minbiocabanon/DoMini/videosurveillance/README.md

Videosurveillance
=====

Ce répertoire contient un fichier texte avec mes notes ayant servi à tester l'API de mes cameras AXIS.
