minbiocabanon/DoMini/periph/poele/README.md

Hardware

	mesure capacité reservoir par ultrason :
	http://www.seeedstudio.com/wiki/Grove_-_Ultrasonic_Ranger

==== Software
Poele.ino
   need library mstimer2 : http://playground.arduino.cc/Main/MsTimer2
   
   ultrasonic ranger github   
   https://github.com/Seeed-Studio/Grove_Ultrasonic_Ranger
