minbiocabanon/DoMini/serveur/bdd/pytribdd/README.md

pytribdd.py
========

Script lancé manuellement en cas de besoin (en général, le script de nettoyage de la bdd quotidien n'a pas fonctionné)

#OBLIGATOIRE : utilisation avec une date en arguments
	$python pytribdd.py 2017-01-01
	
	de 2017-01-01 à 'maintenant' : ne conserve qu'une donnée par heure et le min/max pour les tables indiquées dans le code
