minbiocabanon/DoMini/serveur/bdd/tribdd/README.md

pytribdd.py
========
Script lancé quotidiennement par une action CRON

#utilisation sans arguments
	$python pytribdd_edf.py 
	
	ne converse que les releves de debut de chaque heure pour  le jour J - NB_JOUR (NB_JOUR en dur dans le code)
	
#utilisation avec une date en arguments
	$python pytribdd.py 2017-01-01
	
	ne converse que les releves de debut de chaque heure pour  l'intervalle de temps : "date en argument" jusqu'à "jour actuel - NB_JOUR" (NB_JOUR en dur dans le code)

========
A faire avant de compiler : 
 - Renomer passwd_.h en passwd.h
 - Compléter les informations pour la connexion à MySQL :
	- user -> nom de l'utilisateur de la base
    - password -> mot de passe de l'utilisateur 
    - database = "domotique"; ("domotique" est le nom de la base par défaut, à modifier si vous avez changer le nom)
	- server = "localhost"; (ne pas modifier sauf si vous savez de ce que vous faite)
