minbiocabanon/DoMini/periph/voletroulant/Cablage moteur Somfy.pdf

Branchement, cablage moteur Somfy de store banne électrique | Page 1
http://www.conseils-store.com/index.php?store=bead_mess&id=1872 | 05/02/2011 10:57:17

ACCUEIL
Conseils store

FORUM
sur les stores

CONSEILS SUR LES STORES POUR DECORER ET PROTEGER FENETRE , VERANDA ET TERRASSE

La motorisation
invisible
Découvrez notre
motorisation invisible
de volets battants !
www.motorisation-habitat. com
Volet Roulant
0561190190
Installation -
Dépannage Toulouse
Volet Roulant - Volet
Electrique...
toulouse.accord-assistance .fr

mdp motor
Micromoteurs toutes
technologies 30000
solutions , livraison
48h
www.mdpmotor.fr

Store
Large Gamme de
Stores Tous Les Sites
Marchands Sont Ici !
www.LeGuide.com/Stores

Store Banne
Vous cherchez un
store banne?
Comparez les prix des
stores !
Cherchons.com/Store_
banne
Câblage Téléphonique | Découvrez nos solutions pour réseau mise en place | & | maintenance | www.miditelecom.fr
Vente store enrouleur | Découvrez nos nombreux modèles de stores à enrouleur, | à partir de | 10€ | www.ParlonsDeco.fr/Store -
*Nos Stores *SUN PROTECT | Stores extérieurs, | store terrasse, | Brises soleil, | Voiles d'ombrage | www.sunprotect.fr
Stores pour Fenetres | Jusqu'à - | 65 | % | de remises sur nos Stores,Films Solaires et Film Déco. | www.StoreSurMesure.com

Lecture du message : stores , moteur et motorisation

Retour Accueil du Forum

SUJET : Branchement, cablage moteur Somfy de store banne électrique Email (anti- spam) : mathieu .fougs_- at- _orange .fr - Posté le : 25- 04- 2009
Titre : Branchement , cablage moteur Somfy de store banne électrique

Bonjour.
Étant novice en électricité , je recherche le branchement électrique pour raccorder un store banne de marque Monsieur Store avec une motorisation SOMFY à moteur SLT 50 .

J'ai acheté le store électrique d' occasion à peine 300 euros à mon voisin qui a déménagé . Il n'a plus la notice pour brancher le moteur du store banne et le programmer.

Il y a 4 fils qui sortent du moteur : bleu , noir, marron et jaune-vert. J 'ai une idée de branchement mais je préfère être sûr en ayant le bon schéma de câblage.
Merci d'avance pour vos réponses.

Sujet / réponse de : Schéma cablage

Email (anti- spam) : dev-premierprix _- at- _voila.fr - Posté le : 30 -06 -2009 Titre : Schéma de raccordement de motorisation Somfy de store banne

Bonjour,

Avant de parler électricité , il faut avant tout parler sécurité.

AVANT-PROPOS : des consignes de sécurité importantes à connaitre.
Le raccordement d’une motorisation de store banne (ou volet roulant) doit être effectué en conformité avec la norme NFC 15- 100. En électricité domestique, il y a des dangers de blessure par électrocution . Le raccordement doit être fait par un technicien qualifié et agrée!
De plus , si vous ne branchez pas correctement votre motorisation de store, vous risquez de faire un court- circuit et d’abimer le moteur. Le non-respect des instructions d’installation annule la responsabilité du constructeur et la garantie sur le produit .
Ne s'improvise pas électricien qui veut. Dans l' électricité domestique, il y a des normes, il y a des risques de chocs électriques, il y a des façons de câbler...
Si vous n' êtes pas un bricoleur compétent et averti , il faut faire raccorder la motorisation de votre store banne par une personne qualifiée.
En outre, il faut tenir les personnes à distance de l’installation tant que celle-ci n’est pas terminée. Avant d’intervenir sur l’installation , il faut impérativement couper le disjoncteur sur votre tableau électrique en amont. Enfin, lors de la connexion, il convient de respecter les prescriptions des entreprises de distribution d’ électricité locales, ainsi que les directives pour locaux mouillés et humides selon VDE 0100.

Le câblage de votre motorisation de marque Somfy, actionneur SLT 50 :
Ci- dessous un extrait de la documentation technique Somfy, actionneurs SLT 50 - SLT 60, moteurs spécifiques pour store banne coffre.

Recommandation de la notice technique Somfy
Les appareils avec câble en PVC de type H05 - VVF doivent être réservés aux usages internes , sauf si les câbles sont mis sous conduit.
Attention : afin d'être conforme à la norme d’installation NFC 73800, vous devez prévoir en amont sur le circuit électrique, un dispositif de coupure omnipolaire dont la distance d'ouverture des contacts est de 3mm minimum. Ces instructions concernant la section des câbles font références aux normes électriques françaises et sont données à titre indicatif.

Schéma de câblage, branchement du moteur Somfy SLT 50 - SLT 60 :

Branchement, cablage moteur Somfy de store banne électrique | Page 2

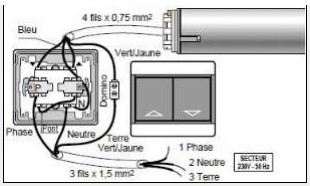
[picture p57: figure]
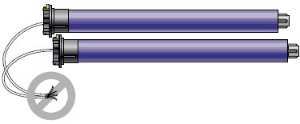
[picture p58: figure]
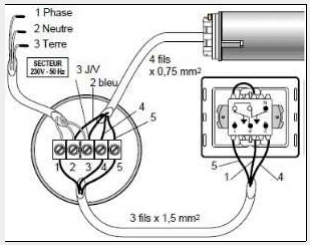
[picture p59: figure]

http://www.conseils-store.com/index.php?store=bead_mess&id=1872 | 05/02/2011 10:57:17

Dans le cas de plusieurs actionneurs Somfy :

Ne pas brancher deux ou plusieurs actionneurs sur le même inverseur . Utilisez impérativement une commande groupée. Ne pas utiliser les interrupteurs utilisés couramment pour les éclairages domestiques.
Ne pas brancher deux interrupteurs inverseurs sur une motorisation. Ces appareils sont munis d’une fixation du type M : si le câble d’alimentation de cet appareil est endommagé, il doit être remplacé par le câble d’alimentation spécial ( choisir la référence dans le catalogue de SOMFY).

Je viens de vous envoyer la documentation technique complète par mail de l’actionneur SLT 50 – SLT 60. Cela étant, n’ oubliez pas que sans compétence en électricité , vous devez vous adresser à un installateur agrée.

Pour vous informer sur les moteurs de store : Store electrique

Sujet / réponse de : Store

Email (anti- spam) : vietrce_- at- _yahoo.fr - Posté le : 23- 01- 2010
Titre : Toile de store electrique

Je souhaite changer les toiles de mes stores électriques .
Je n'arrive pas à trouver de distributeurs. De plus quels sont les caractéristiques à connaitre sachant que je n'ai aucune documentation sur les stores que j'ai acheté avec la maison ?
Merci d'avance.

Sujet / réponse de : François

Email (anti- spam) : stores 33_-at-_orange.fr - Posté le : 23- 01 -2010 Titre : RE : Toile de store

Bonjour,

Vous allez être obligé de passer par un Storiste , les caractéristiques à connaitre sont la longueur et la largeur du store, et si le tube d'enroulement et la barre de charge son a gorge ou à clips , avec une photo de profil rien de plus facile.

Cordialement ,
François de Stores 33 , Storiste en Gironde, Tel 06 24 63 36 85

Branchement, cablage moteur Somfy de store banne électrique | Page 3
http://www.conseils-store.com/index.php?store=bead_mess&id=1872 | 05/02/2011 10:57:17

Sujet / réponse de : Store

Email (anti- spam) : dev-premierprix _- at- _voila.fr - Posté le : 23 -01 -2010 Titre : RE : Changer la Toile de store

Pour vous informer sur les toiles de store banne :

Conseils pour choisir une toile de store banne : Toile store banne
Vous trouverez quelques critères de choix, du premier prix jusqu'à la toile haut de gamme...

Conseils pour changer une toile de store banne : Changer, remplacer toile store banne Vous trouverez dans cet article tout un tas d'infos pour remplacer la toile de son store banne.

Sujet / réponse de : vincent

Email (anti- spam) : mvincentleroy_-at-_gmail.com - Posté le : 17 - 04- 2010
Titre : RE : Branchement, cablage moteur Somfy de plusieurs stores

Merci pour ces beaux schémas de câblage.

Pour ma part, j'ai 2 moteurs + 2 moteurs. Comment dois- je mis prendre ? On m' a parlé de GR3 ? c' est quoi ? pourquoi ? Comment ?

Merci.

Sujet / réponse de : François

Email (anti- spam) : stores 33_-at-_orange.fr - Posté le : 17- 04 -2010
Titre : RE : Branchement, cablage moteur Somfy de store banne électrique

Bonjour,

"( ...) comment dois-je mis prendre ?"
Pour faire quoi ? Avec quoi ?

Merci d'exposer clairement votre problème si vous voulez une réponse.

Quel type d'installation avez- vous précisément ? Qu'avez- vous comme équipement : marque, modèle , à commande radio ou filaire ... ?
Que voulez- vous faire exactement ? une commande groupée de plusieurs stores ?

Cordialement ,
François de Stores 33 , Storiste en Gironde, Tel 06 24 63 36 85

Sujet / réponse de : Vincent

Email (anti- spam) : mvincentleroy_-at-_gmail.com - Posté le : 19 - 04- 2010 Titre : RE : Branchement, cablage moteur Somfy de plusieurs stores

J'ai un mur de deux fenêtres, large environ de 4 mètres.
Je mets deux stores motorisés par fenêtre.
Au total, j'ai donc 4 moteurs Somfy et je souhaite faire le câblage de ces 4 moteurs sachant que c'est commandé par télécommande radio + interrupteur radio RTS.
2 moteurs qui remontent ensemble ou les 4, suivant le choix souhaité.
Ai- je été plus clair ? Connaissez- vous le câblage pour mon installation ?

Sujet / réponse de : François

Email (anti- spam) : stores 33_-at-_orange.fr - Posté le : 21- 04 -2010
Titre : RE : Branchement, cablage moteur Somfy de store banne électrique

Bonjour,

Si vous êtes en commande radio, il n'y a pas besoin de commande groupé mais de faire la programmation de votre télécommande, ou de vos télécommandes .

Le mieux serai une télécommande TELIS 4 qui vous permettra de commander chaque stores indépendamment, ou simultanément .

Pour le branchement soit les moteurs sont à automatisme embarqué ( à l'intérieur du moteur) et le raccordement est tout simplement Phase Neutre Terre, soit l'automatisme est déporte et il faut les raccordé au bornier, en respectant les symboles de Montée- Descente et Phase Neutre Terre .

Cordialement ,
François de Stores 33 , Storiste en Gironde, Tel 06 24 63 36 85
Devis Gratuits | Comparez Les Devis Pour Vos Volets, | Stores, | Portails | & | Fenêtres | 123devis .com/Alu-PVC-Bois
enrouleur de protection | enrouleurs de protection enrouleurs à ressorts | www.cetic.fr
Veremeraude | Films solaires et stores films, | des solutions adaptées à vos besoins | www.veremeraude.com
Vu sur | l'émission déco M 6 Brise-Soleil Solisystème Installateur exclusif | www.bredok.com

Branchement, cablage moteur Somfy de store banne électrique | Page 4
http://www.conseils-store.com/index.php?store=bead_mess&id=1872 | 05/02/2011 10:57:17

AJOUTER UNE REPONSE PERTINENTE Ce forum n'est pas un espace de publicité, merci.

Nom (25 caractères maxi.)

Email

RE: Branchement, cablage moteur Somfy de store banne électrique | Titre (100 caractères maxi.)

le message ici ...

Recevoir les réponses par mail : | Oui | Non

Poster le message ...

Annonces
Google
Moteur Electrique | Store Veranda | Store Fenetre | Cablage Electrique
Annuaire store | Store d'occasion | Contact | copyright © 2008 - 2010 conseils -store.com - mentions légales
Partenaire célibat : retrouvez le guide pour draguer sur internet afin de rencontrer l'âme soeur.

2008 - 2010 © copyright : Tous les textes de conseils-store .com sont protégés par la loi française sur le copyright , conformément aux dispositions du Code de la propriété intellectuelle français. Sans la permission écrite et signée de conseils- store.com, il est interdit au visiteur de copier les articles, les textes de quelque façon que ce soit, entièrement ou partiellement.
