minbiocabanon/DoMini/periph/_datasheet/Affectation_GPIO_JeeNode.gif

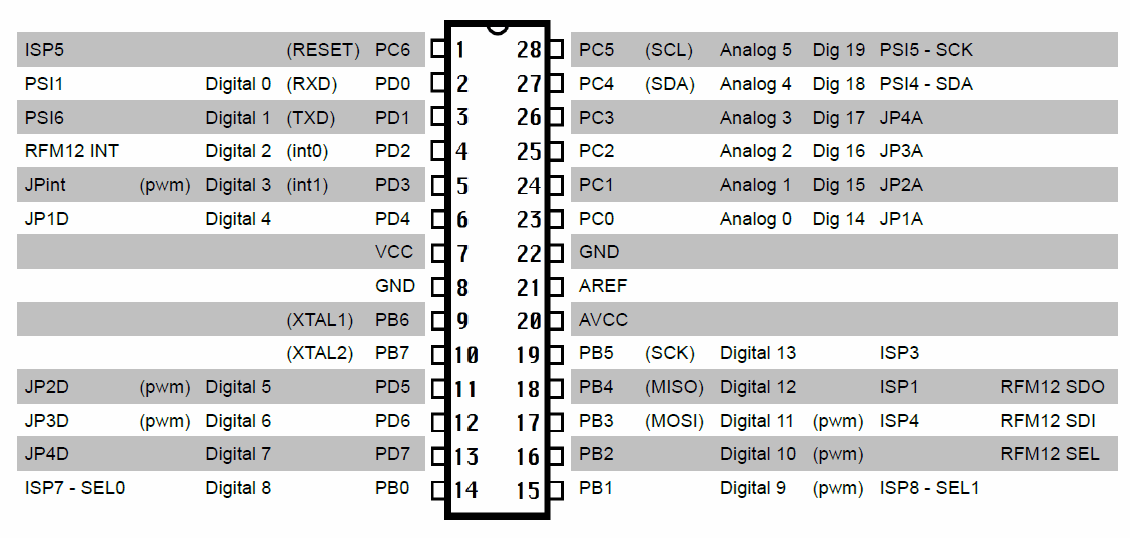
periph/_datasheet/Affectation_GPIO_JeeNode.gif
