minbiocabanon/DoMini/periph/compteur_edf/img/TeleInfoEDF.jpg

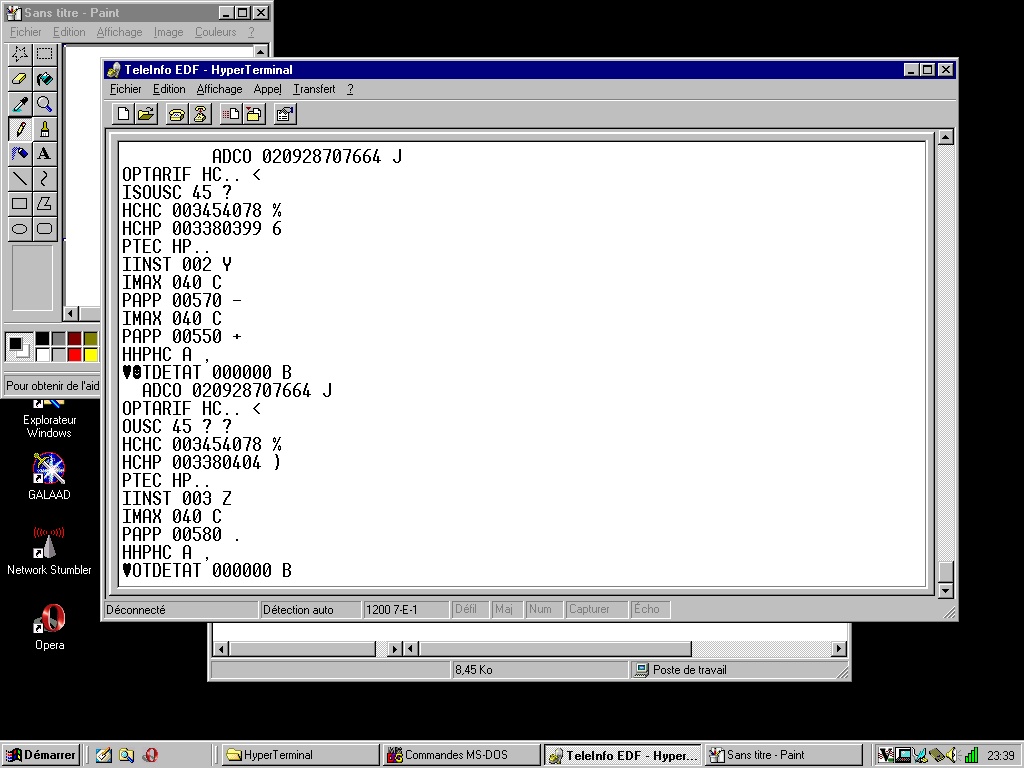
periph/compteur_edf/img/TeleInfoEDF.jpg
