minbiocabanon/DoMini/periph/poele/IMG/IMAG0336.jpg

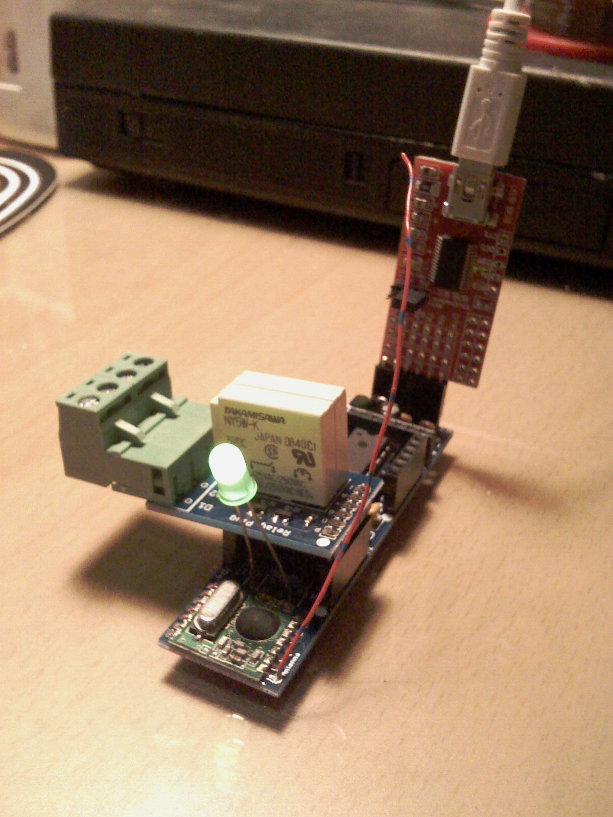
periph/poele/IMG/IMAG0336.jpg
