minbiocabanon/DoMini/periph/poele/Synoptique_poele.jpg

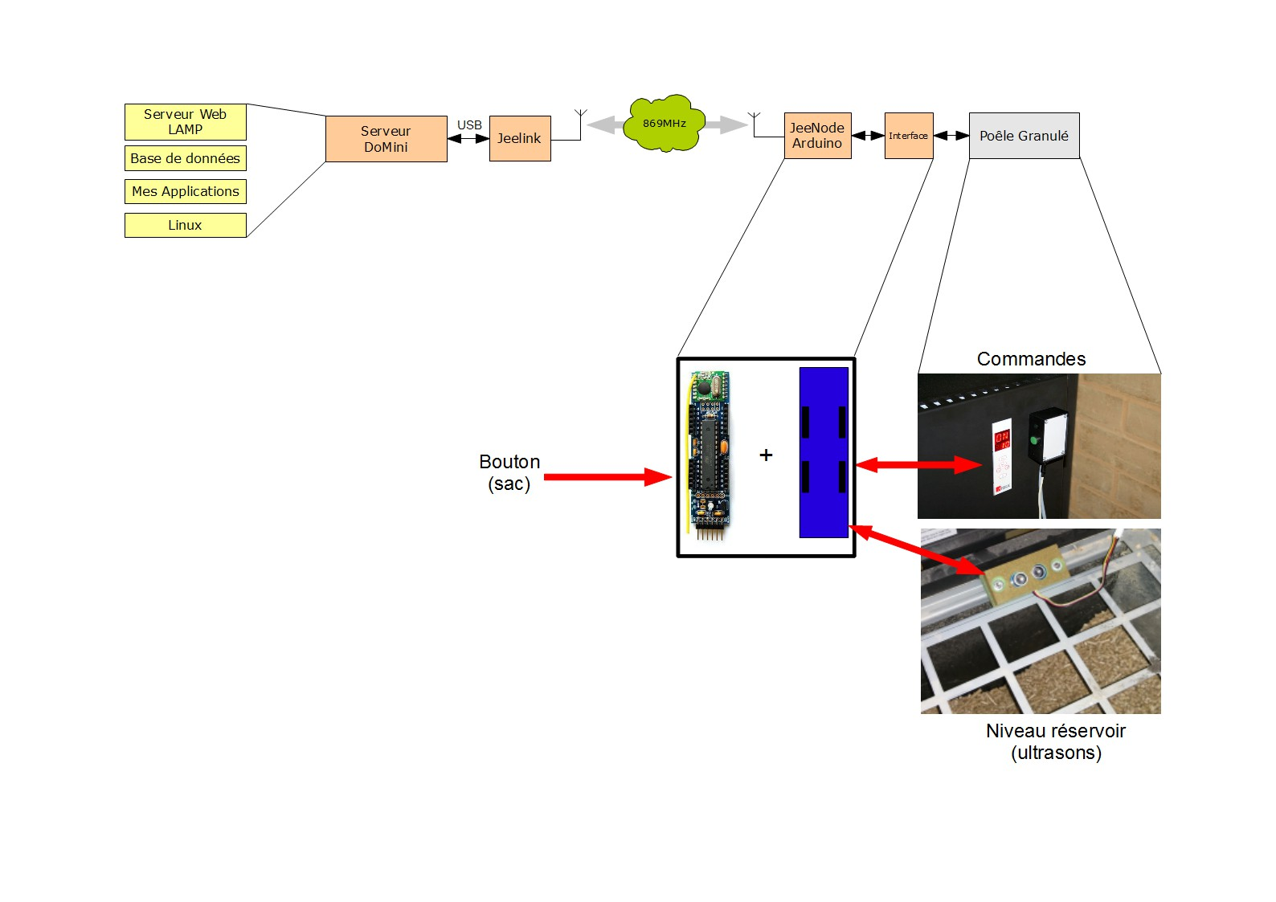
periph/poele/Synoptique_poele.jpg
