minbiocabanon/DoMini/periph/sonde_temperature/img/Screenshot_THERMO_HUMID_OK.jpg

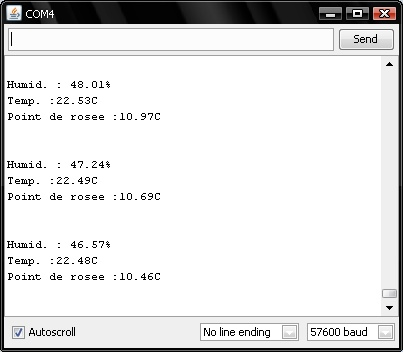
periph/sonde_temperature/img/Screenshot_THERMO_HUMID_OK.jpg
