minbiocabanon/DoMini/periph/station_meteo/PCB/20140119_pcb_arduino_004.jpg

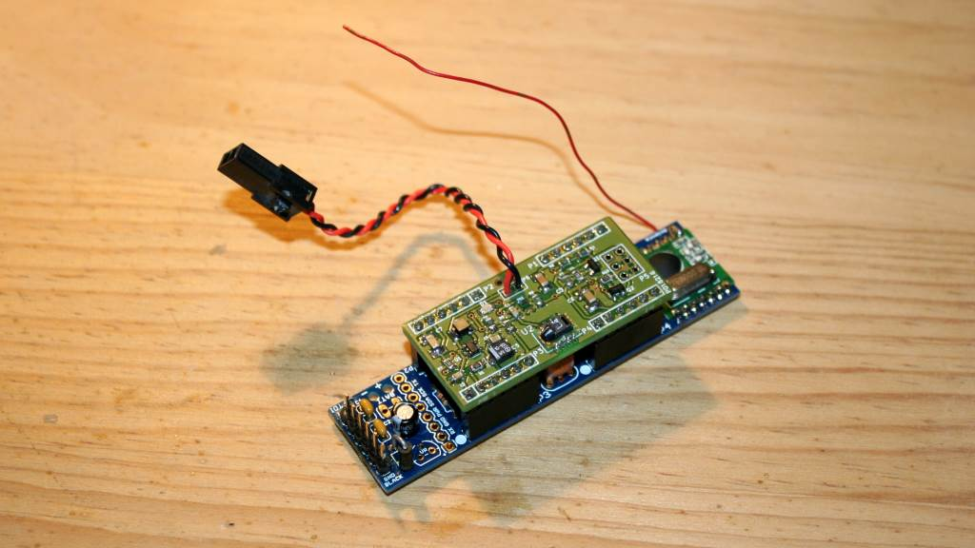
periph/station_meteo/PCB/20140119_pcb_arduino_004.jpg
