minbiocabanon/DoMini/periph/station_meteo/PCB/legend1.png

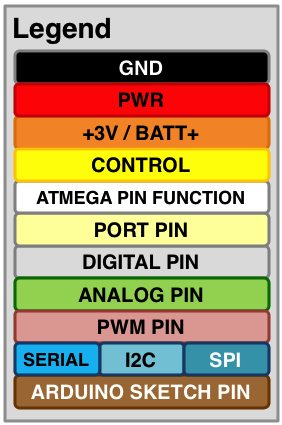
periph/station_meteo/PCB/legend1.png
