minbiocabanon/DoMini/periph/station_meteo/PCB/qrc-jn-v6-part.png

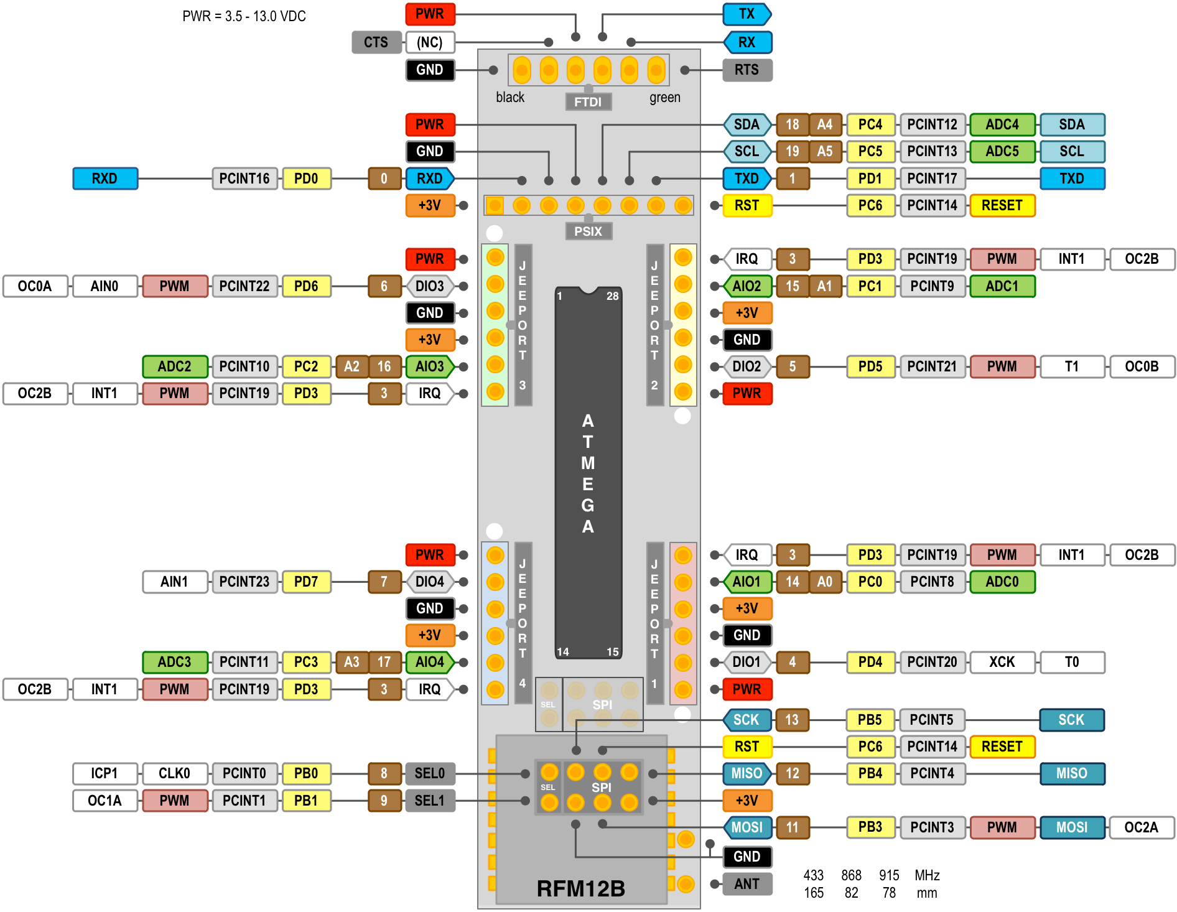
periph/station_meteo/PCB/qrc-jn-v6-part.png
