minbiocabanon/DoMini/periph/station_meteo/PCB/V1/CI13-001-bottomview.png

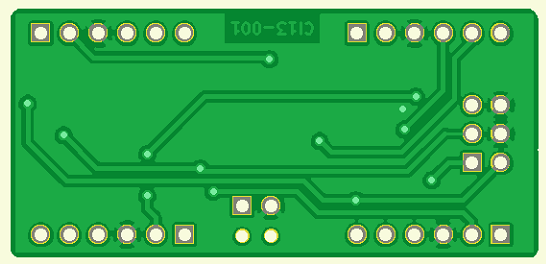
periph/station_meteo/PCB/V1/CI13-001-bottomview.png
