minbiocabanon/DoMini/periph/station_meteo/PCB/V1/ci13-001-schematic.png

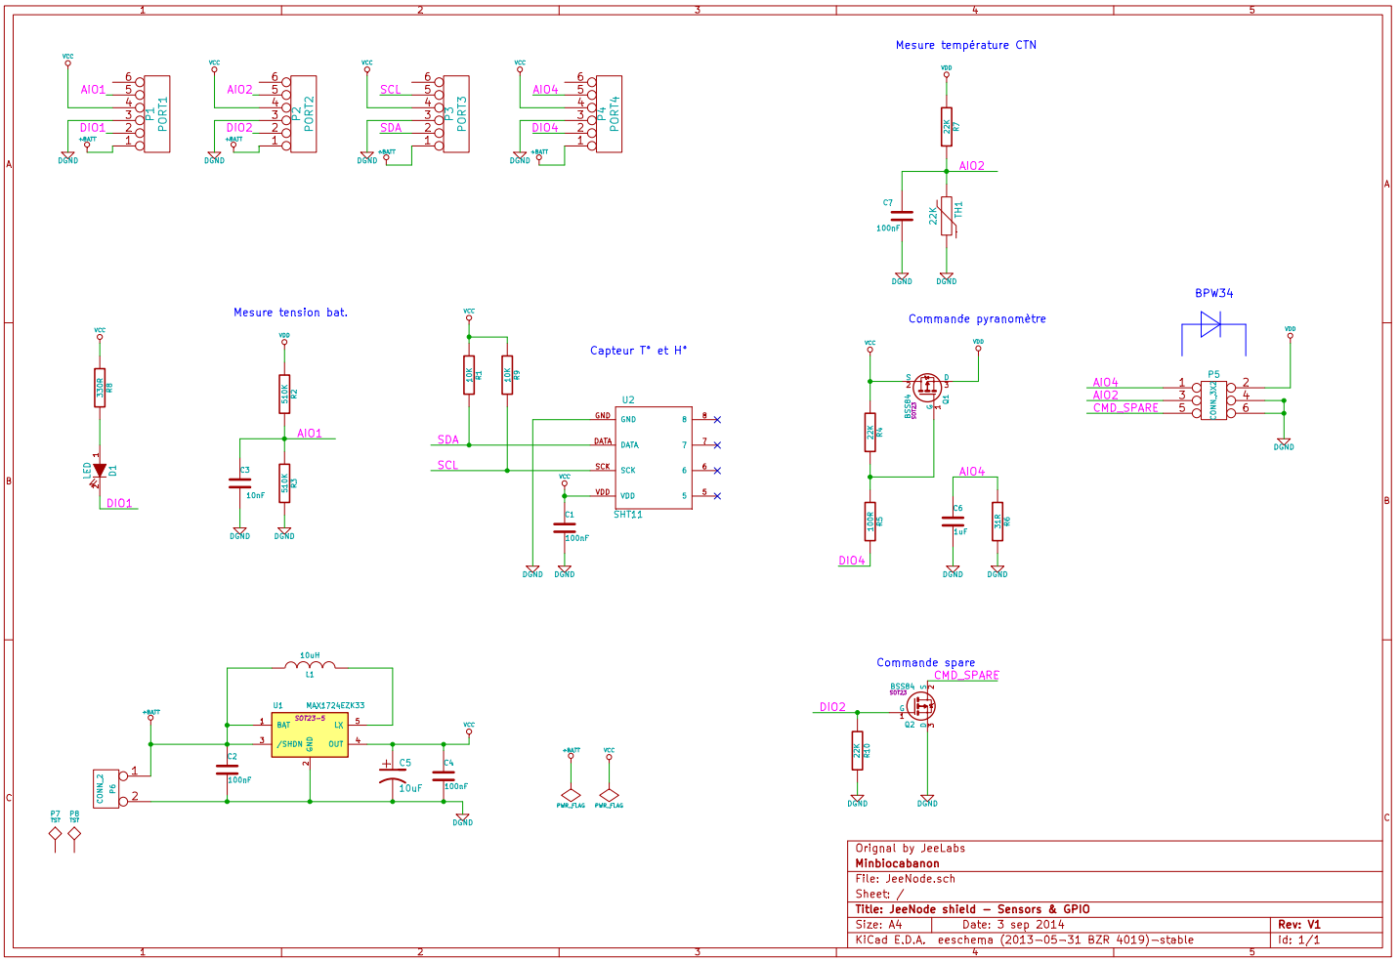
periph/station_meteo/PCB/V1/ci13-001-schematic.png
