minbiocabanon/DoMini/periph/station_meteo/PCB/V1/CI13-001-topview.png

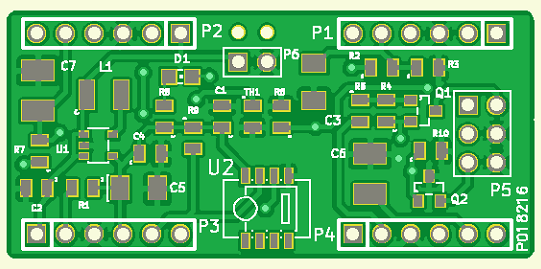
periph/station_meteo/PCB/V1/CI13-001-topview.png
