minbiocabanon/DoMini/periph/vmcdf_bypass/doc/Relais_porte_Poulailler_ON_OFF.jpg

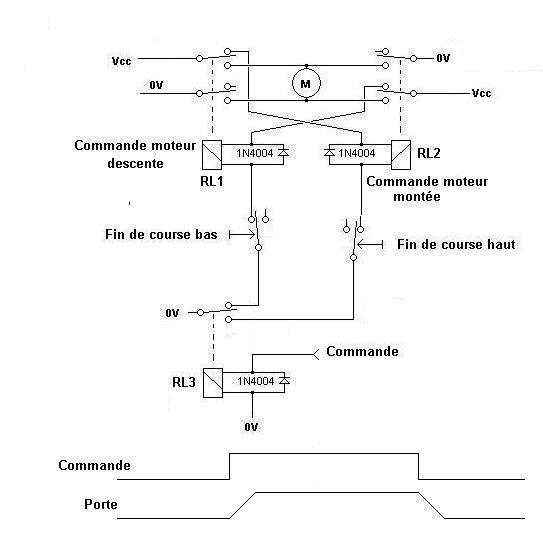
periph/vmcdf_bypass/doc/Relais_porte_Poulailler_ON_OFF.jpg
