minbiocabanon/DoMini/periph/vmcdf_bypass/doc/sch_cmd_simple.png

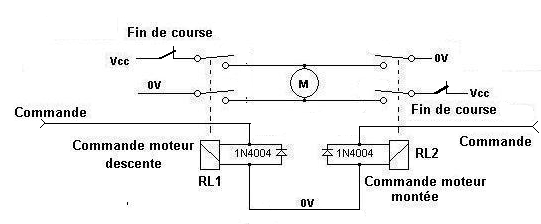
periph/vmcdf_bypass/doc/sch_cmd_simple.png
