minbiocabanon/DoMini/periph/vmcdf_bypass/img/bypass_PC_01.JPG

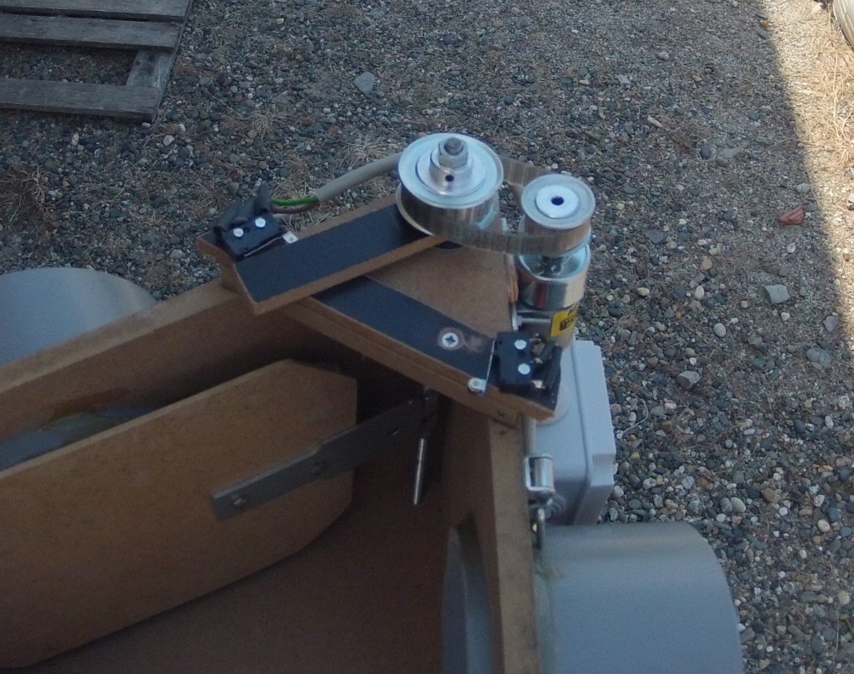
periph/vmcdf_bypass/img/bypass_PC_01.JPG
