minbiocabanon/DoMini/periph/vmcdf_bypass/img/bypass_PC_02.JPG

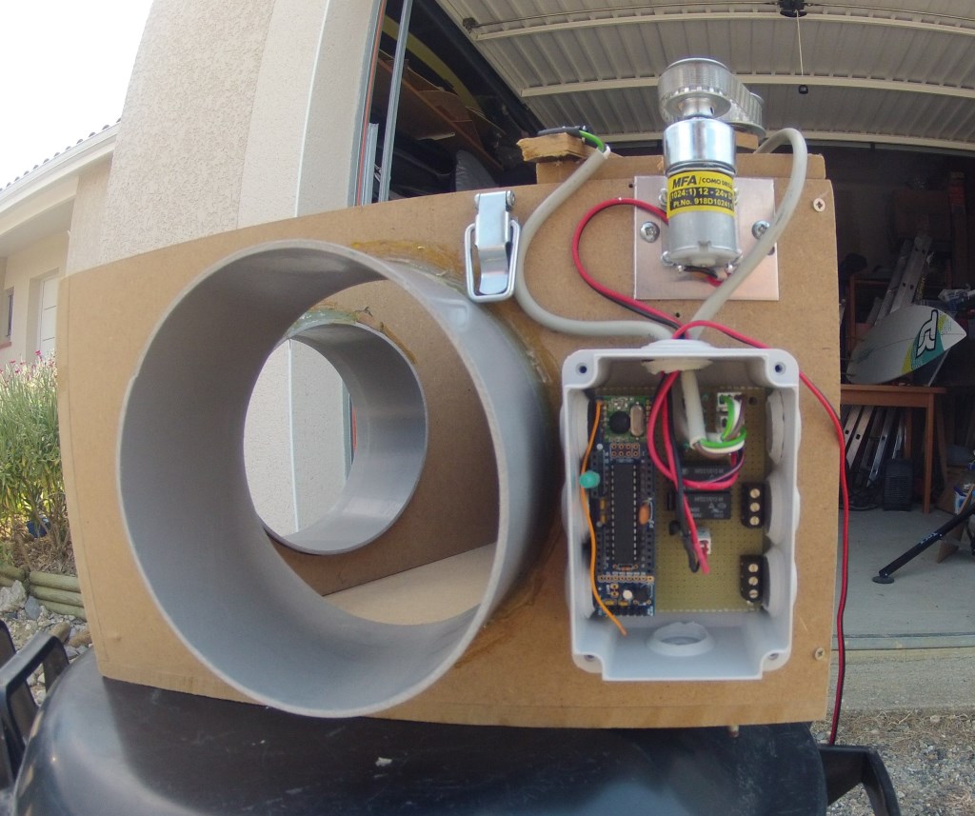
periph/vmcdf_bypass/img/bypass_PC_02.JPG
