minbiocabanon/DoMini/periph/voletroulant/Cablage_Somfy_Telis_4_RTS.png

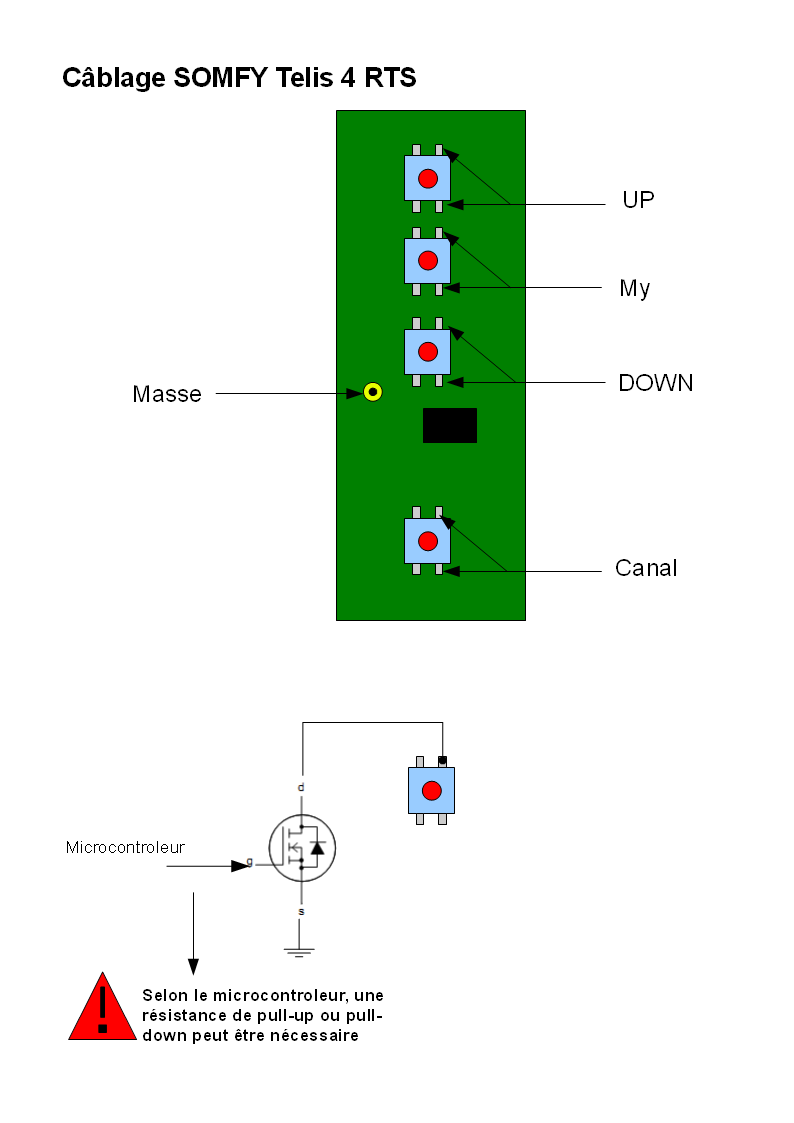
periph/voletroulant/Cablage_Somfy_Telis_4_RTS.png
