minbiocabanon/DoMini/serveur/www/domini/img/plan_ventilation.jpg

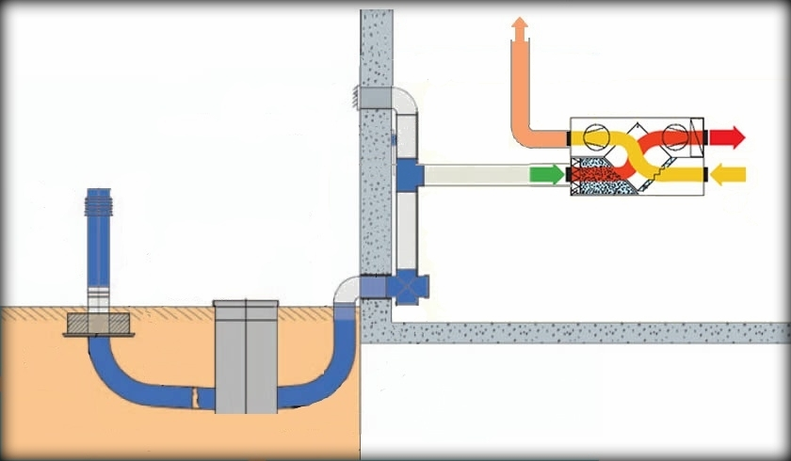
serveur/www/domini/img/plan_ventilation.jpg
