minbiocabanon/DoMini/serveur/www/domini/script/sejour_full.jpg

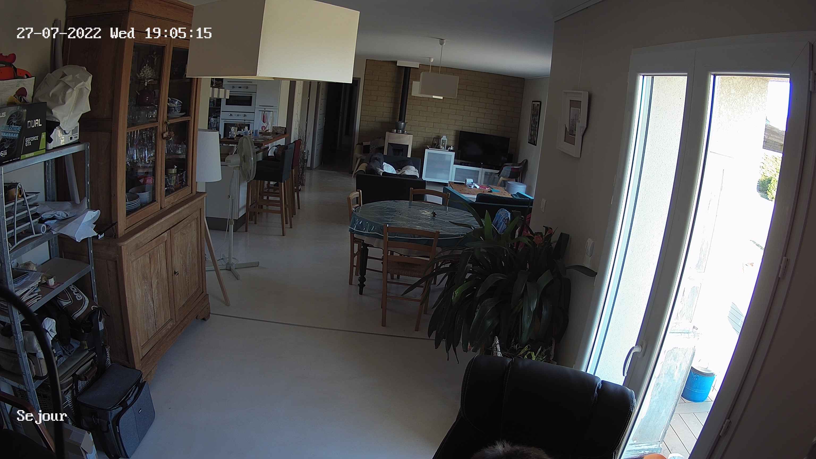
serveur/www/domini/script/sejour_full.jpg
