minbiocabanon/DoMini/serveur/www/domini/webcam/garage2.jpg

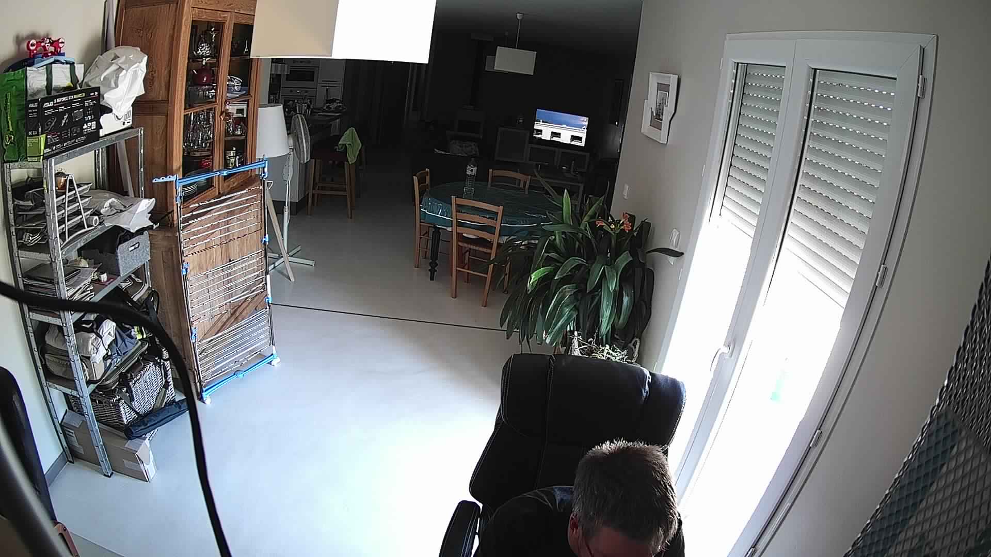
serveur/www/domini/webcam/garage2.jpg
