minbiocabanon/DoMini/serveur/www/domini/webcam/garage_full.jpg

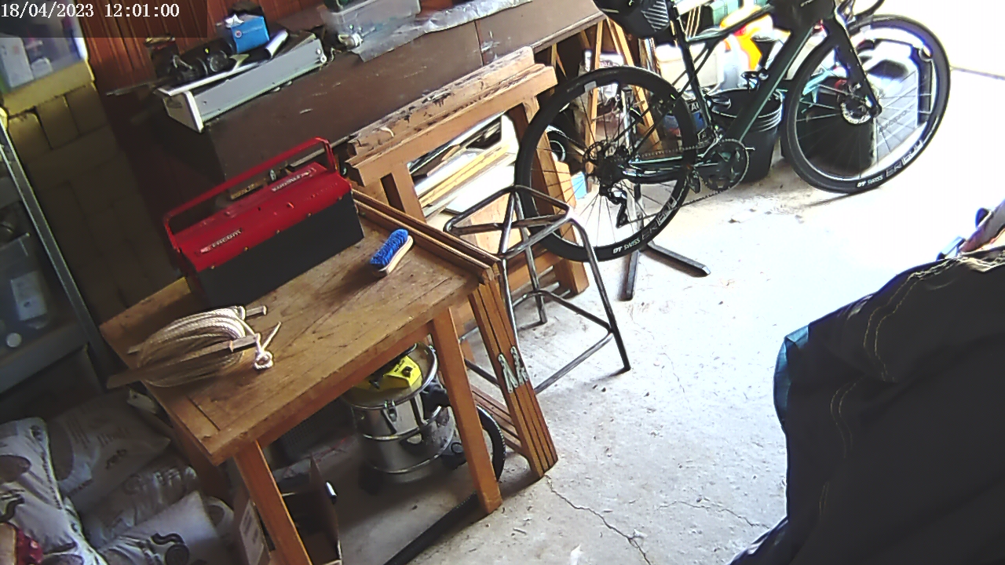
serveur/www/domini/webcam/garage_full.jpg
