minbiocabanon/DoMini/serveur/www/domini/webcam/kiwi.jpg

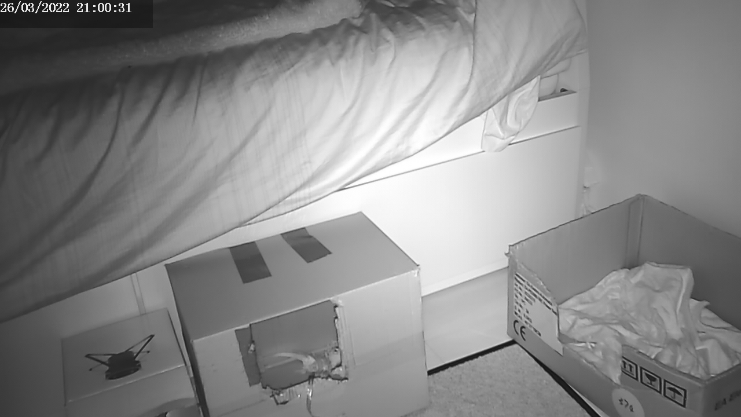
serveur/www/domini/webcam/kiwi.jpg
