minbiocabanon/DoMini/serveur/www/domini/webcam/porche.jpg

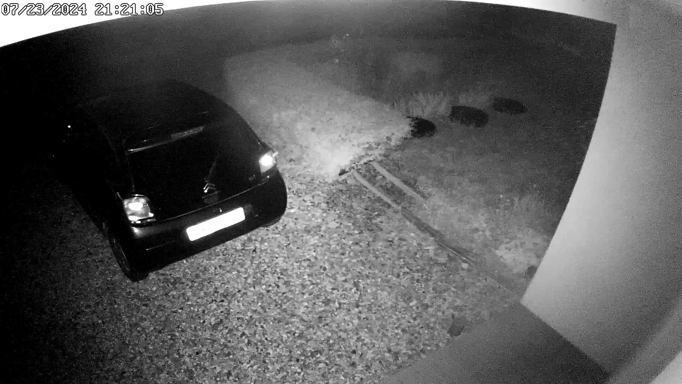
serveur/www/domini/webcam/porche.jpg
