minbiocabanon/DoMini/serveur/www/domini/webcam/sejour.jpg

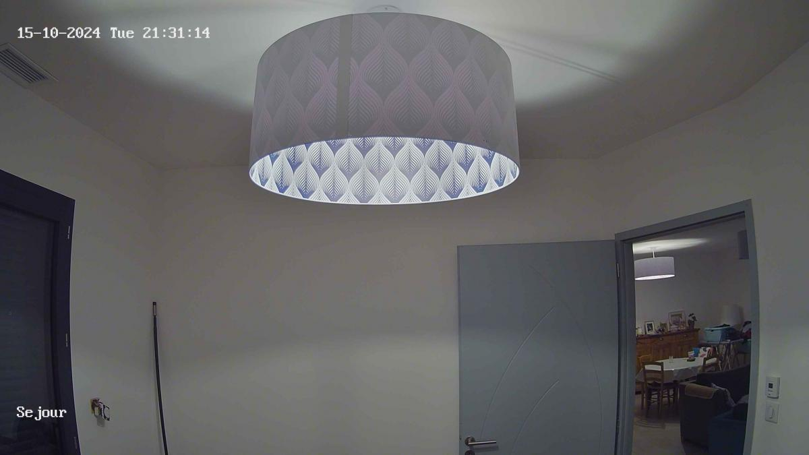
serveur/www/domini/webcam/sejour.jpg
