minbiocabanon/DoMini/periph/station_meteo/PCB/V1/BOM-JeeNode.ods

N° de circuit |  | CI13-001
 |  |  |  |  |  |  |  | Total | 11,81 €
 |  |  |  |  |  | TVA | 1,196
ref | value | footprint | Fabricant | Designation | Fournisseur | code commande |  | Prix U TTC
PCB | CI13-001 |  |  | 2 couches , 46,61 x 21,97mm | Eurocircuit |  | 3,51 € | 4,20 €
C1 | 100nF | SM0805 |  | Condensateur |  |  | 0,00 € | 0,00 €
C2 | 100nF | SM0805 |  | Condensateur |  |  | 0,00 € | 0,00 €
C3 | 10nF | SM1206 |  | Condensateur |  |  | 0,00 € | 0,00 €
C4 | 100nF | SM0805 |  | Condensateur |  |  | 0,00 € | 0,00 €
C5 | 10uF | SM1206POL |  |  |  |  | 0,00 € | 0,00 €
C6 | 1uF | SM1210L |  | Condensateur |  |  | 0,00 € | 0,00 €
C7 | 100nF | SM1210L |  | Condensateur |  |  | 0,00 € | 0,00 €
D1 | LED | LED-0805 | Avago / Osram | Led verte CMS | Conrad Farnell | 153376–62 2099239 | 0,20 € | 0,24 €
L1 | 10uH | SM1210 | murata | Inductance | Conrad | 536616-62 | 0,25 € | 0,30 €
P1 | PORT1 | TSW-106-07-L-S | SAMTEC | Barette 6pts male droite | Conrad Farnell | 733993-62 1668590 | 0,15 € | 0,18 €
P2 | PORT2 | TSW-106-07-L-S | SAMTEC | Barette 6pts male droite | Farnell | 733993-62 1668590 | 0,15 € | 0,18 €
P3 | PORT3 | TSW-106-07-L-S | SAMTEC | Barette 6pts male droite | Farnell | 733993-62 1668590 | 0,15 € | 0,18 €
P4 | PORT4 | TSW-106-07-L-S | SAMTEC | Barette 6pts male droite | Farnell | 733993-62 1668590 | 0,15 € | 0,18 €
P5 | CONN_3X2 | pin_array_3x2 |  |  |  |  | 0,00 € | 0,00 €
P6 | CONN_2 | PIN_ARRAY_2X1 |  |  |  |  | 0,00 € | 0,00 €
Q1 | BSS84 | SOT23 | NXP | Transistor unipolaire CMS MOSFET | Conrad Farnell | 153060–62 1510765 | 0,28 € | 0,33 €
Q2 | BSS84 | SOT23 | NXP | Transistor unipolaire CMS MOSFET | Conrad Farnell | 153060–62 1510765 | 0,28 € | 0,33 €
R1 | 10K | SM0805 |  | Résistance |  |  | 0,00 € | 0,00 €
R2 | 510K | SM0805 |  | Résistance |  |  | 0,00 € | 0,00 €
R3 | 510K | SM0805 |  | Résistance |  |  | 0,00 € | 0,00 €
R4 | 22K | SM0805 |  | Résistance |  |  | 0,00 € | 0,00 €
R5 | 100R | SM0805 |  | Résistance |  |  | 0,00 € | 0,00 €
R6 | 31R | SM0805 |  | Résistance |  |  | 0,00 € | 0,00 €
R7 | 22K | SM0805 |  | Résistance |  |  | 0,00 € | 0,00 €
R8 | 330R | SM0805 |  | Résistance |  |  | 0,00 € | 0,00 €
R9 | 10K | SM0805 |  | Résistance |  |  | 0,00 € | 0,00 €
R10 | 22K | SM0805 |  | Résistance |  |  | 0,00 € | 0,00 €
TH1 | 22K | SM0805 | vishay | Résistance CTN | Farnell | 2103181 | 0,14 € | 0,17 €
U1 | MAX1724EZK33 | SOT23-5 | MAXIM IC | Convertisseur DC/DC Step-up/down | Farnell | 1673190 | 4,61 € | 5,51 €
U2 | SHT11 | sht11-SHT11 | Sensirion | Capteur de température et humidité I²C | CONRAD Farnell | 503486–62 1590511 |  |  | 36,95 €
