minbiocabanon/DoMini/periph/Identification_Jeenodes.xls

id | Sens | $ : no ACK | trame | Champs |  |  |  |  |  | Commentaires | Exemple
 |  | ! : ACK |  | <val1> | <val2> | <val3> | <val4>
AN1 | Jeenode -> Jeelink | $ | AN1,<val1>,<val2>,<val3>,<val4><CR><LF> | T° en °C x 100 | H° en % x 10 | Pt rosée en °C x10 | Tension batterie en V x100 |  |  | Capteur intérieur
AN2 | Jeenode -> Jeelink | $ | AN2,<val1>,<val2>,<val3>,<val4><CR><LF> | T° en °C x 100 | H° en % x 10 | Pt rosée en °C x10 | Tension batterie en V x100 |  |  | Capteur extérieur
AN3 | Jeenode -> Jeelink | $ | AN3,<val1>,<val2>,<val3>,<val4><CR><LF> | T° en °C x 100 | H° en % x 10 | Pt rosée en °C x10 | Tension batterie en V x100 |  |  | Capteur dans lle Puits canadien
AN4 | Jeenode -> Jeelink | $ | AN4,<val1>,<val2>,<val3>,<val4><CR><LF> | Tension en V x 100 | Tension en V x 100 | - | -
PYR | Jeenode -> Jeelink | $ | PYR,<val1><CR><LF> | Tension en V x 100 |  |  |  |  |  | Flux solaire du pyranomètre
POL | Jeenode <- Jeelink | ! | POL,<val1>,<val2><CR><LF> | ON / OFF (1/0) | Puissance en % | - | - |  |  | Consigne pour le poële à granulés | $POL,1,085
POL | Jeenode <- Jeelink | ! | POL,<val1>,<val2>,<val3><CR><LF> | SYNCHRO (2) | Position menu | - | - |  |  | Message pour synchro le jeenode (menus) avec le poele | $POL,2,2
POL | Jeenode -> Jeelink | ! | POL,<val1>,<val2><CR><LF> | SAC | Nb de sac | - | - |  |  | Envoyé a chaque sac mis dans le reservoir . Sert d'acquittement (TBC) | !POL,SAC,1
POL | Jeenode -> Jeelink | $ | POL,<val1><CR><LF> | NVG | Niveau réservoir en cm | - | - |  |  | Envoyé toutes les 10 minutes, mesure en centimètres. 000 = plein | $POL,NVG,110
VRL | Jeenode -> Jeelink | ! | VRL,<val1>,<val2>,<val3>,<val4><CR><LF> | Position volet (0-100) | Position volet (0-100) | Position volet (0-100) | Position volet (0-100) |  |  | 0 : OUVERT , 100 : FERME , autre : position en % | $VRL,0,0,0,0
VMC | Jeenode -> Jeelink | $ | VMC,<val1>,<val2>,<val3>,<val4>,<val5>,<val6><CR><LF> | T° en °C x 100 | T° en °C x 100 | T° en °C x 100 | H° en % x 10 | VMC ON/OFF | Position bypass (0-100%) | 0 : position PC , 100 : position Ext. , autre : position en %
BPC | Jeenode <- Jeelink | $ | BPC,<val1>,<val2><CR><LF> | Position bypass : (0-100) | VMC ON/OFF |  |  |  |  | 0 : position PC , 100 : position Ext. , autre : position en %
 |  |  |  | <HC> | <HP> | <tarif | <Iinst> | <imax> | <puissance>
EDF | Jeenode -> Jeelink | $ | EDF,<HC>,<HP>,<tarif>,<Iinst>,<imax>,<puissance><CR><LF> | conso heure creuse en Wh | conso heure pleine en Wh | créneau HC ou HP | courant instantané en A | courant max en A | puissance instantanée en W | Données du compteur EDF
TND | Jeenode -> Jeelink | $ | TND,<LAT> ,<LON><CR><LF> | Latitude x10000 | Longitude x 10000 |  |  |  |  | Position du robot tondeuse | $TDN,4379133,110768
