minbiocabanon/DoMini/(list of files, cad)

Other CAD files:
periph/poele/meca/support_telemetre_ultrason.skp
