minbiocabanon/DoMini/docs/Synoptique_DoMini.pdf

## SDCard

Monitoring | (optional : display)

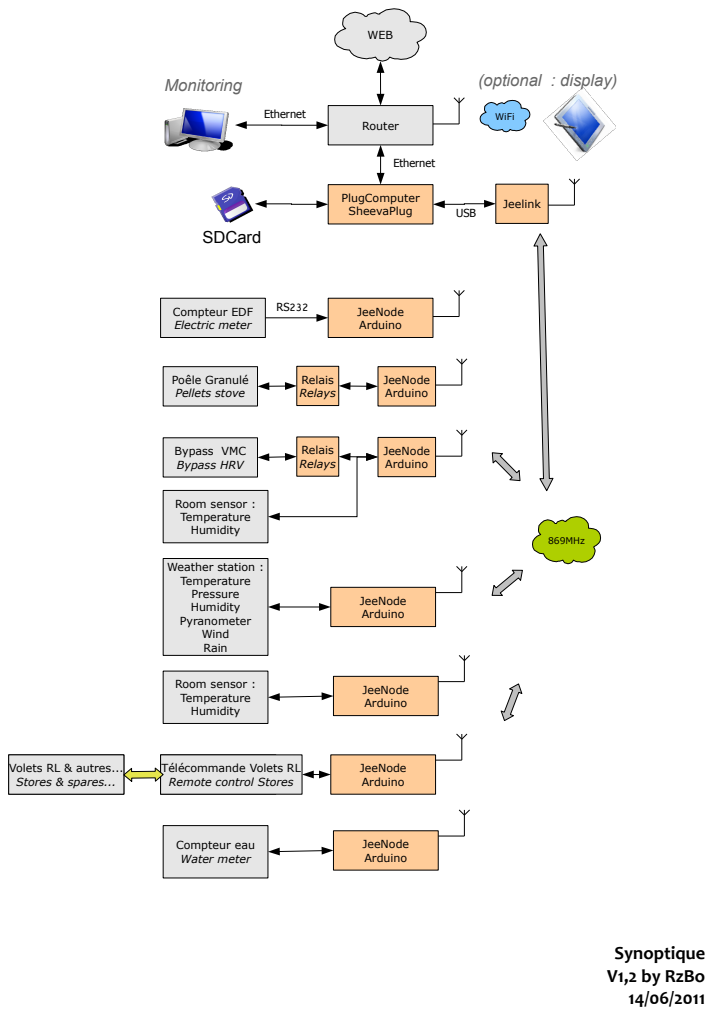
[picture p89: page 1]
WEB; PlugComputer SheevaPlug; Router; Jeelink; 869MHz; Ethernet; USB; WiFi; JeeNode Arduino; Compteur EDF Electric meter; Poêle Granulé Pellets stove; Bypass VMC Bypass HRV; Weather station : Temperature Pressure Humidity Pyranometer Wind Rain; Synoptique V1,2 by RzBo 14/06/2011; Relais Relays; Room sensor : Temperature Humidity; Compteur eau Water meter

Volets RL & autres...
Stores & spares...

Télécommande Volets RL
Remote control Stores
