minbiocabanon/DoMini/periph/sonde_temperature/schema_THERMO_HUMID.pdf

J1

J2

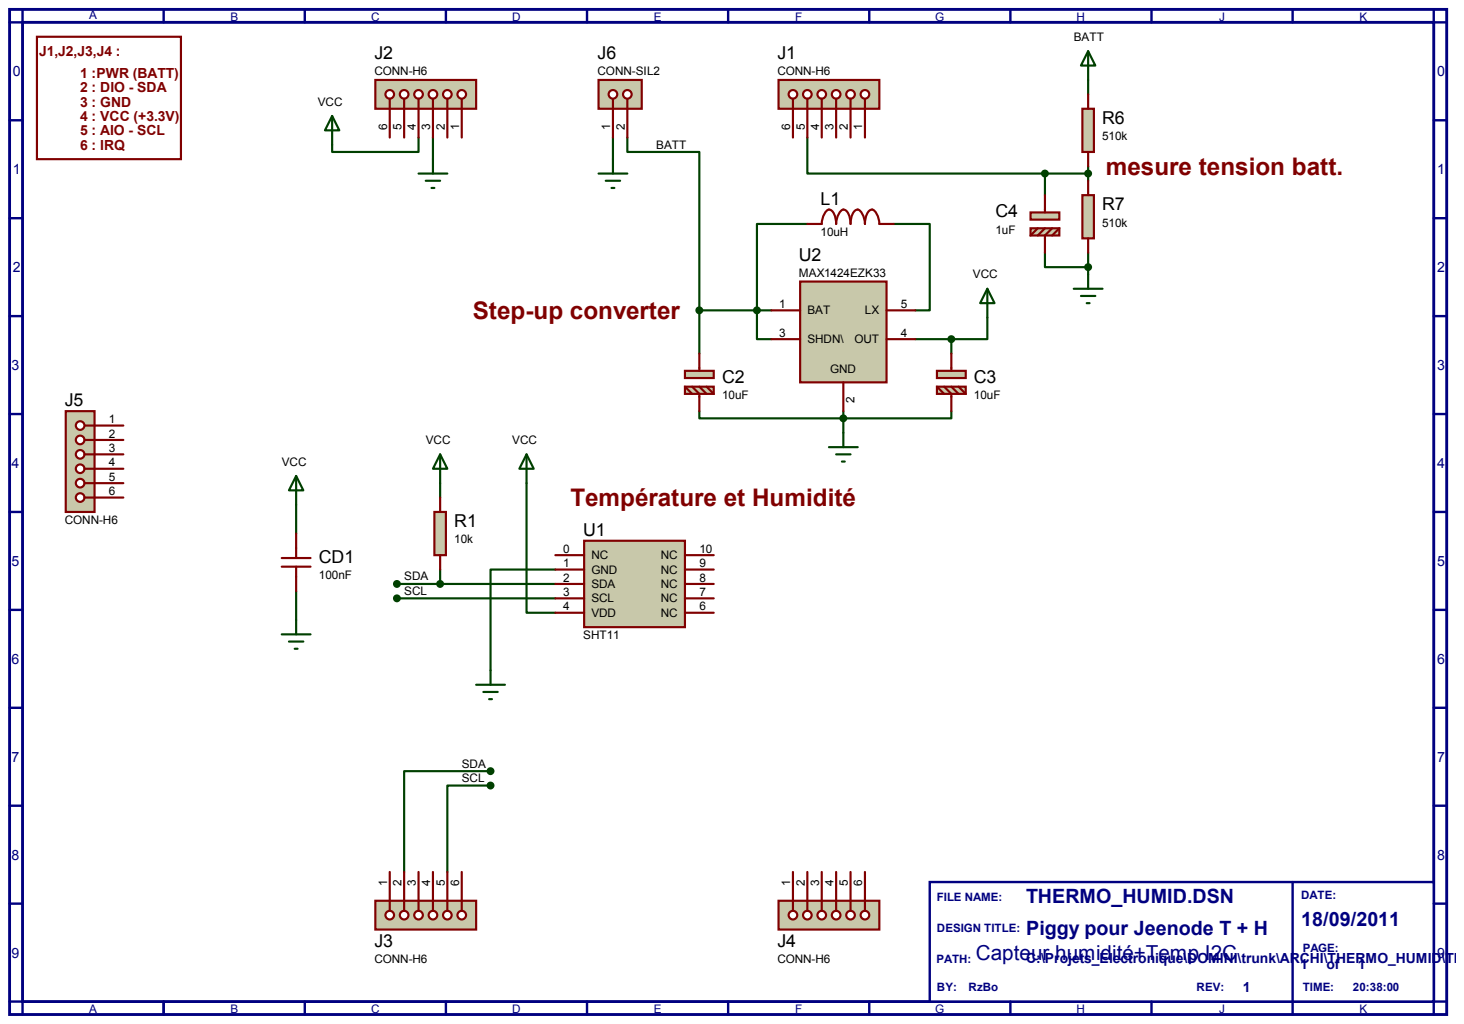
[picture p90: page 1]

FILE NAME:
DESIGN TITLE: Piggy pour Jeenode T + H
Capteur humidité+Temp I2C
