minbiocabanon/DoMini/periph/vmcdf_bypass/Sch_Proto_Commande_relais_bypass.pdf

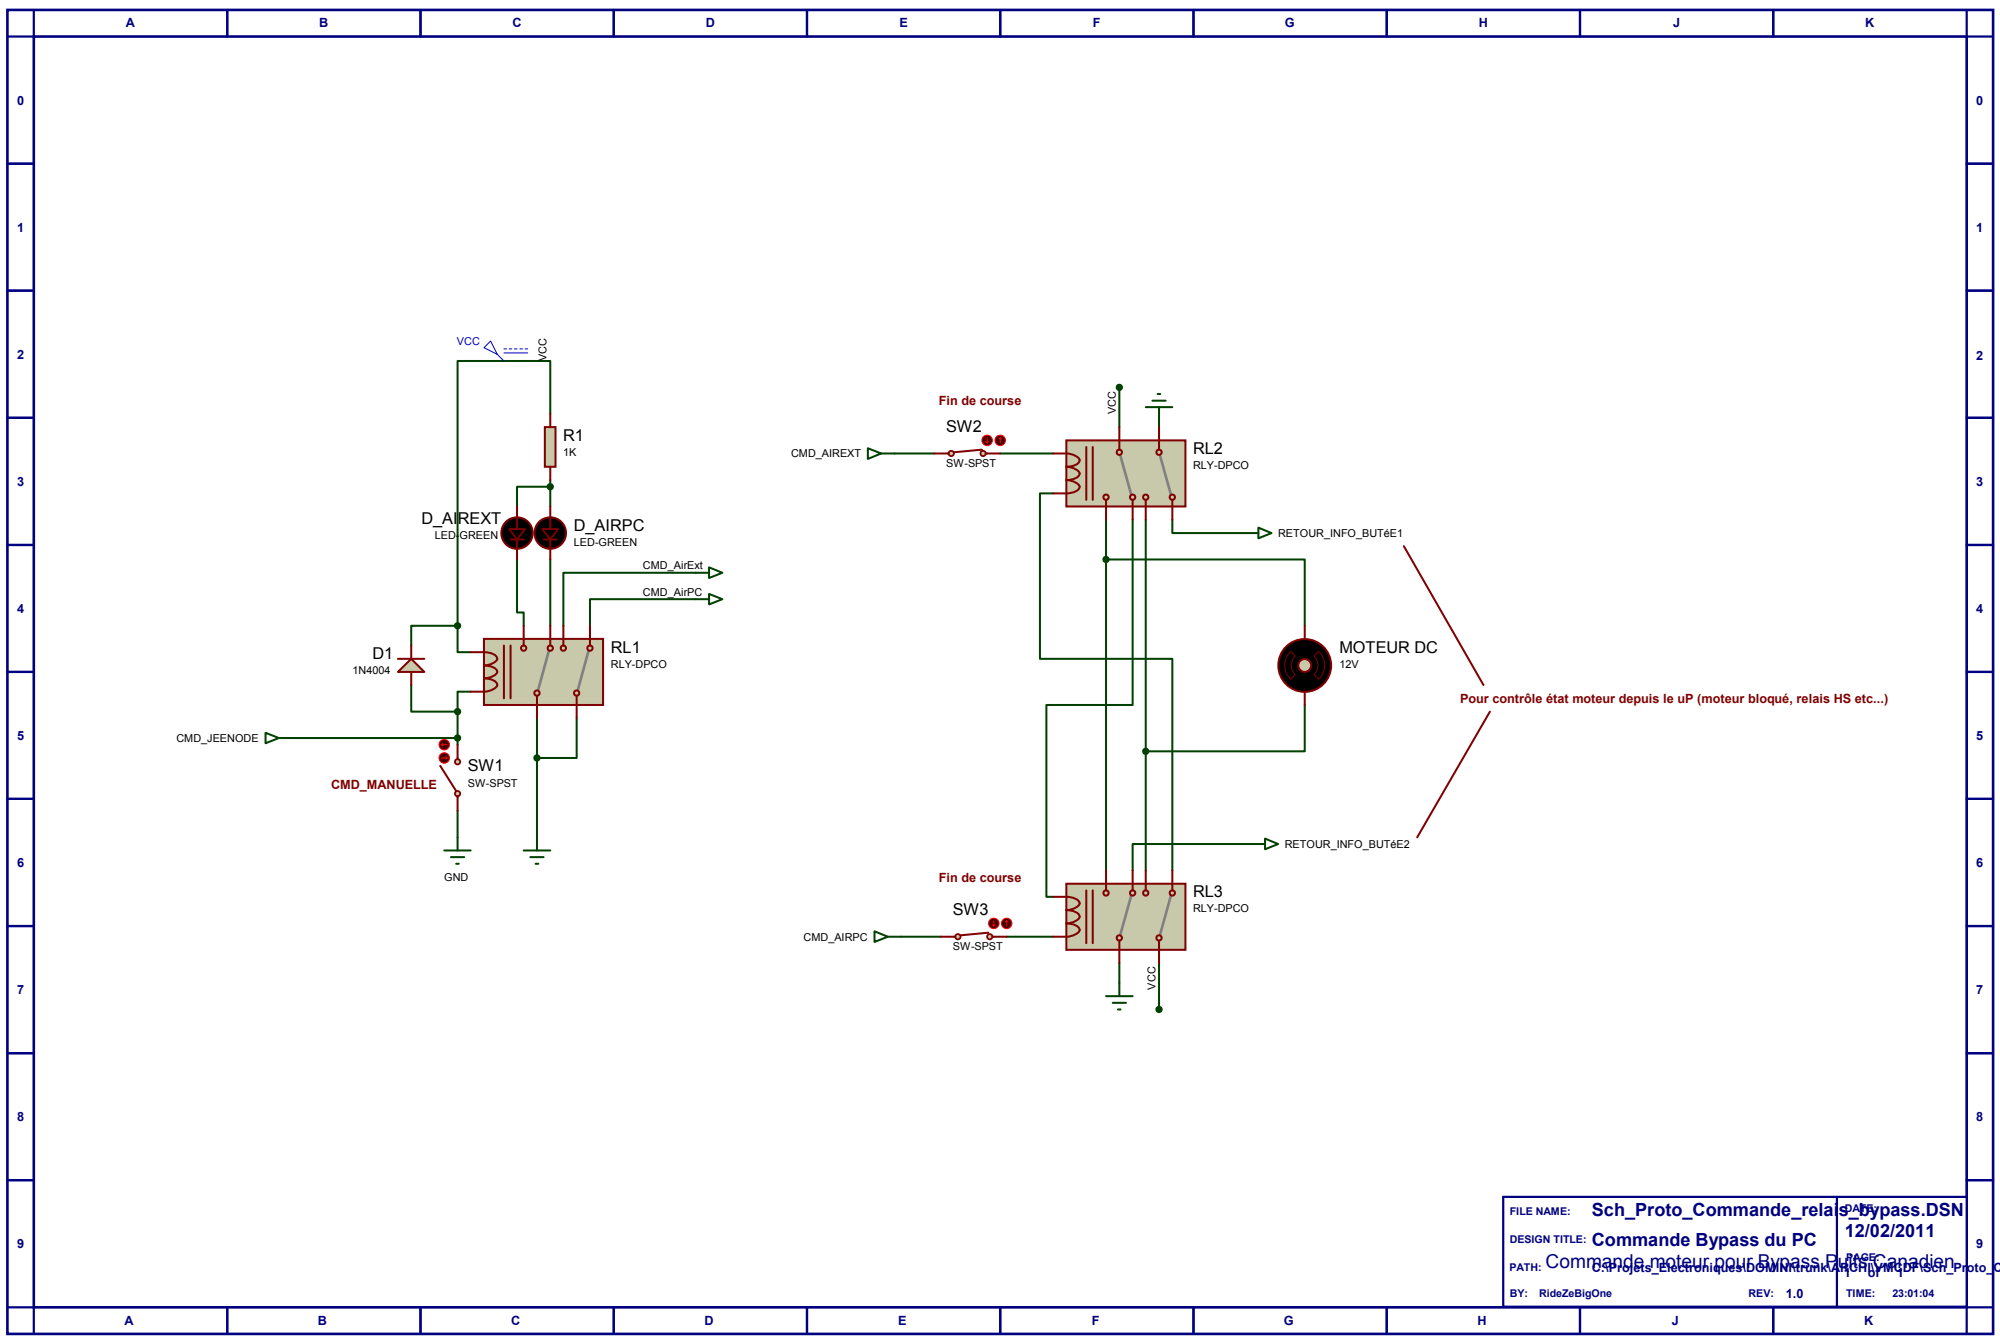
[picture p91: page 1]
DATE:; PAGE:; Sch_Proto_Commande_relais_bypass.DSN 12/02/2011; RideZeBigOne; PATH:; C:\Projets_Electroniques\DOMINI\trunk\ARCHI\VMCDF\Sch_Proto_Commande_relais_bypass.DSN 1; REV: 1.0; TIME:; VCC; CMD_AirExt; CMD_AirPC; GND; SW-SPST; D_AIRPC; LED-GREEN; RLY-DPCO; D_AIREXT; CMD_AIREXT; CMD_AIRPC; MOTEUR DC; RETOUR_INFO_BUTéE2; RETOUR_INFO_BUTéE1; CMD_JEENODE; CMD_MANUELLE

Fin de course

Pour contrôle état moteur depuis le uP (moteur bloqué, relais HS etc...)

FILE NAME:
DESIGN TITLE: Commande Bypass du PC
Commande moteur pour Bypass Puits Canadien
