minbiocabanon/DoMini/periph/station_meteo/PCB/ci13-001-schematic_V2.pdf

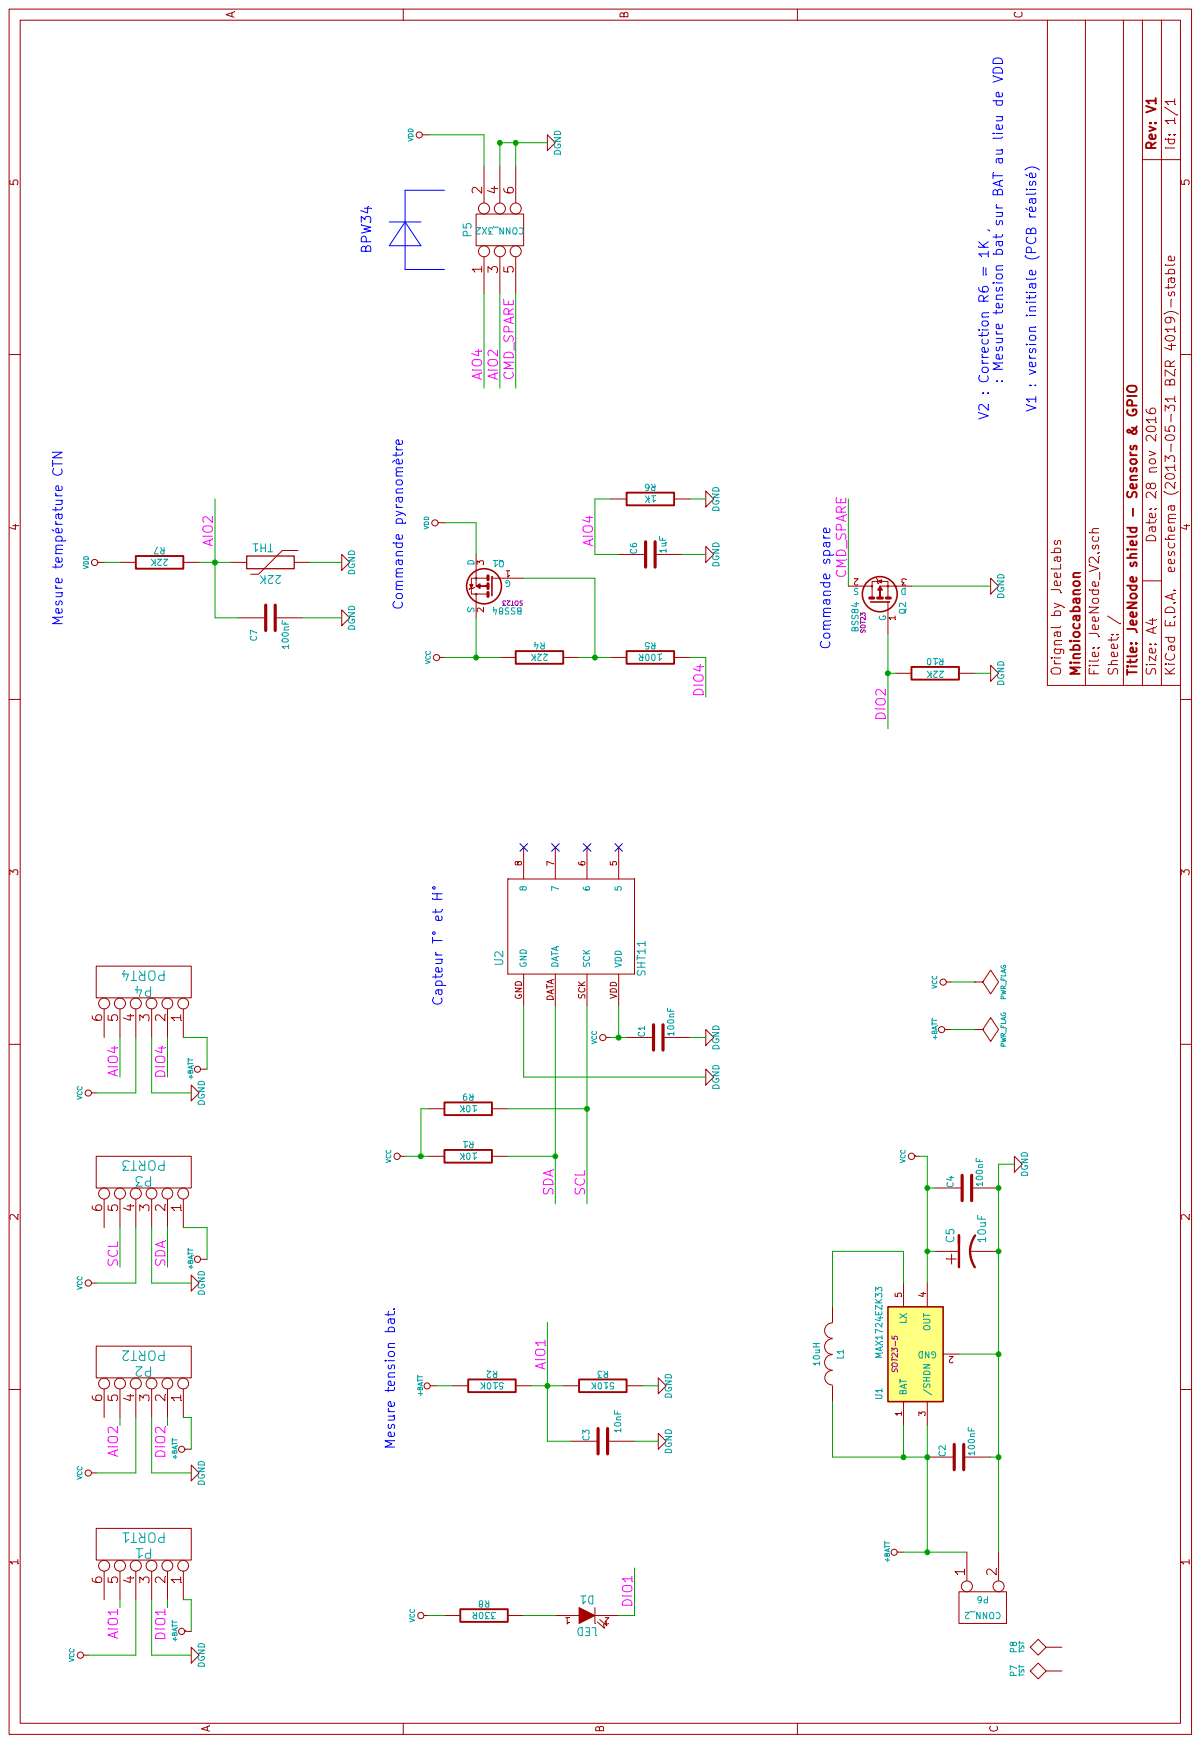
[picture p92: page 1]
