minbiocabanon/DoMini/periph/station_meteo/PCB/V1/ci13-001-schematic.pdf

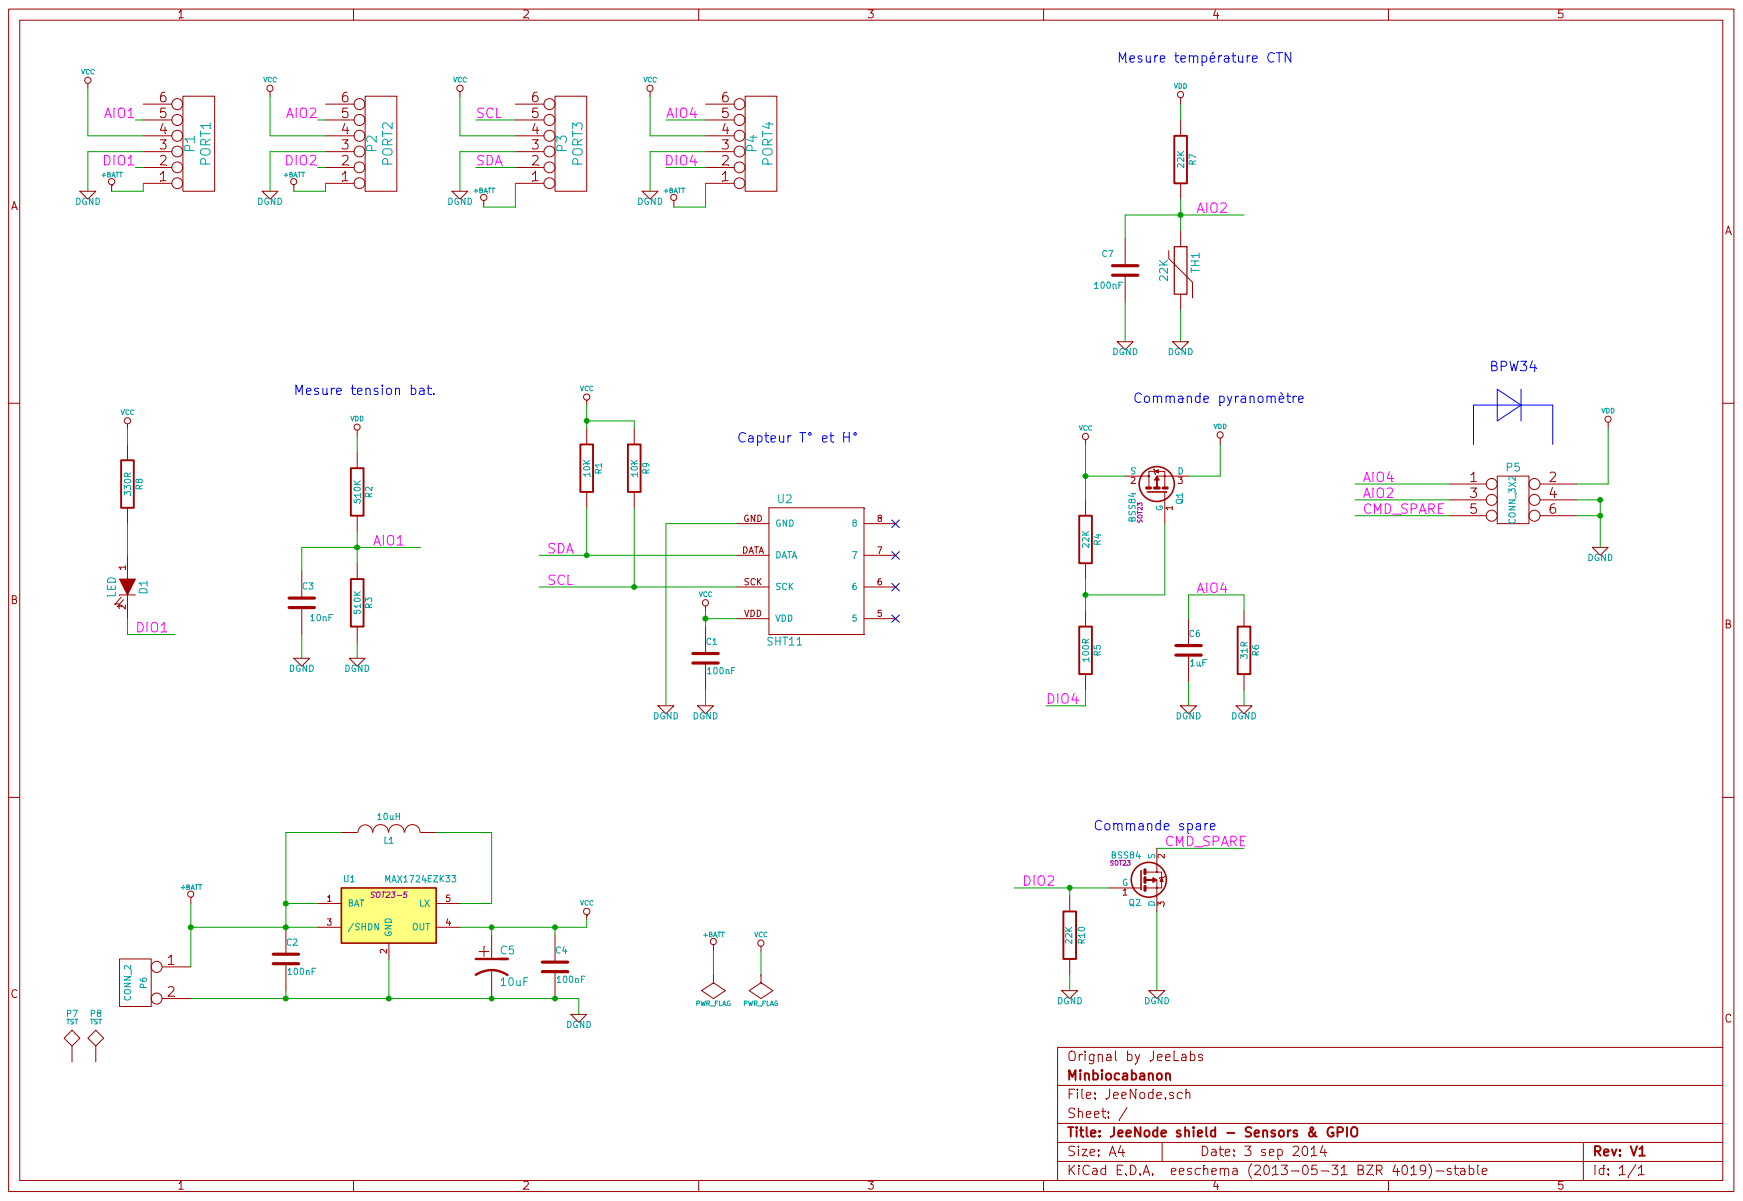
[picture p93: page 1]
