minbiocabanon/DoMini/docs/Synoptique_DoMini_SoftSheevaPLug.pdf

DOMINI | 869MHz

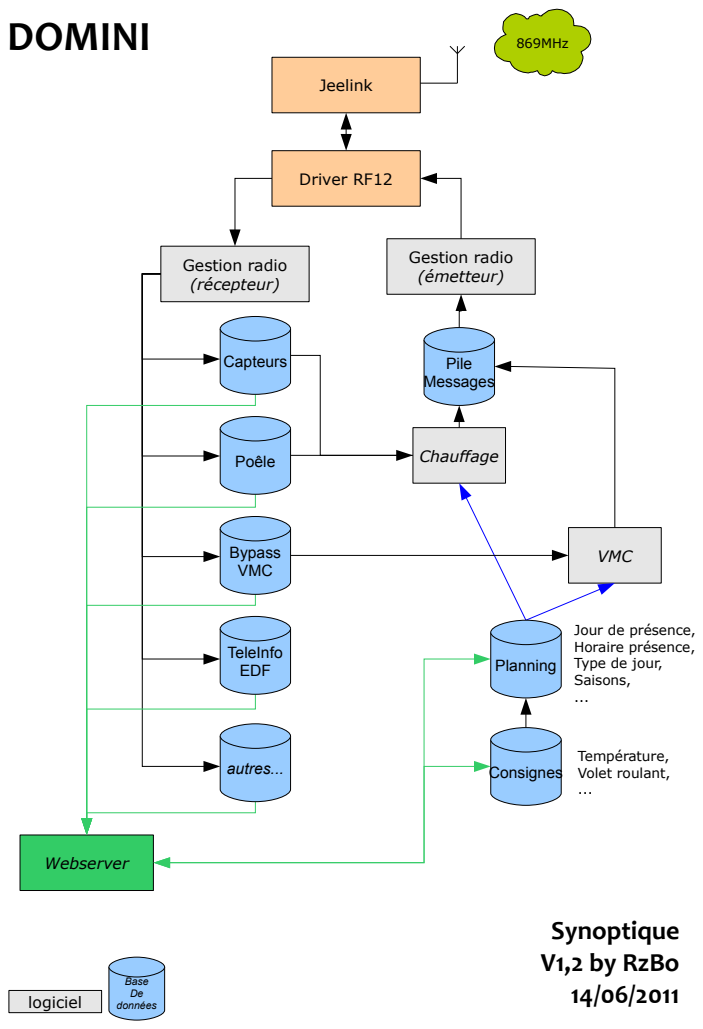
[picture p94: page 1]
Jeelink; Synoptique V1,2 by RzBo 14/06/2011; Driver RF12; Gestion radio (récepteur); Chauffage; VMC; Webserver; logiciel; Gestion radio (émetteur); Capteurs; Poêle; Bypass VMC; TeleInfo EDF; autres...; Pile Messages; Base De données; Planning; Consignes; Température, Volet roulant, ...

Jour de présence,
Horaire présence,
Type de jour,
Saisons,

Decodage :
Réception des messages
Tri et écriture dans les fichiers textes

BDD Capteurs :
Une ligne par période

BDD Poêle :
Acquittement des allumages/extinctions Consignes envoyées

BDD TeleInfo
Données de la téléinfo compteur EDF

BDD BypassVMC
Position PC/Air ext.
Consignes envoyées

VMC :
En fonction de temp. Ext et temp. Int ,planning et consigne Sélection de l'air entrant dans la VMC

Chauffage :
En fonction de temp. Ext et temp. Int ,planning et consigne Pilotage de la hors/en service du poêle + puissance

BDD TeleInfo
Données de la téléinfo compteur EDF
