minbiocabanon/DoMini/serveur/jeelink/jlpcb-131.pdf

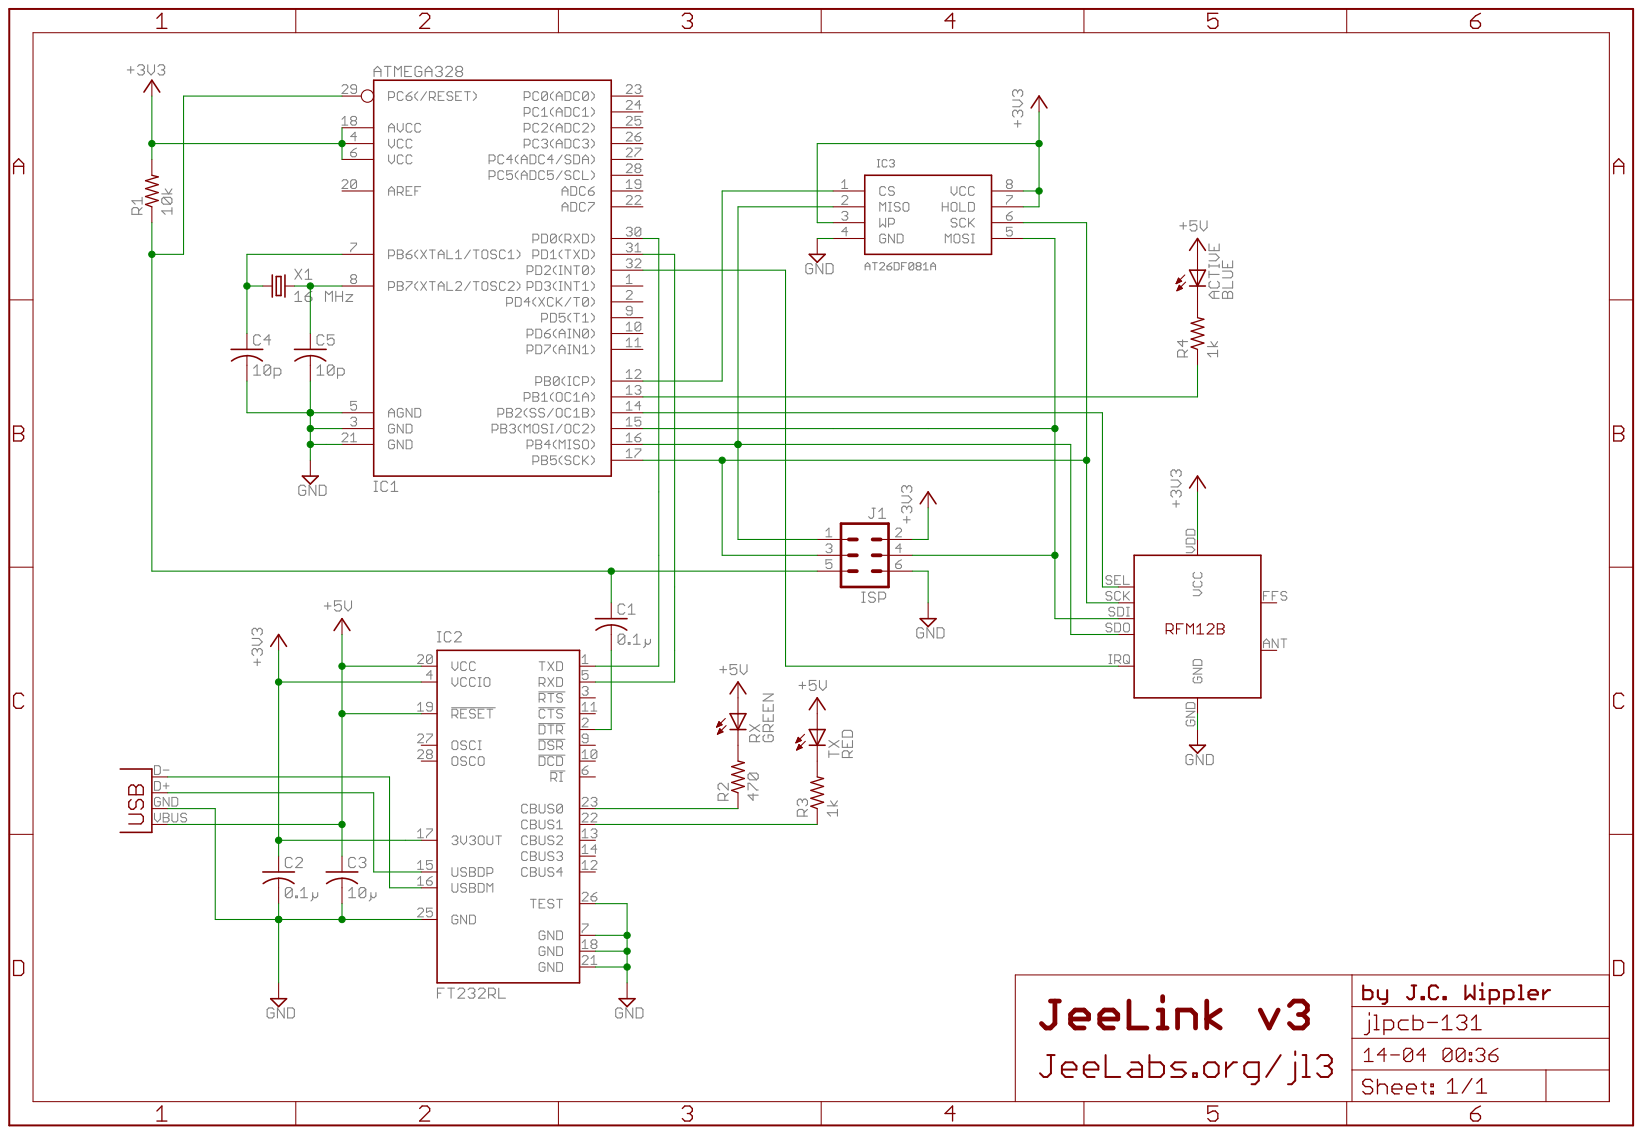
[picture p95: page 1]
