minbiocabanon/DoMini/periph/poele/jeenode_shield_POELE.pdf

J1

J2

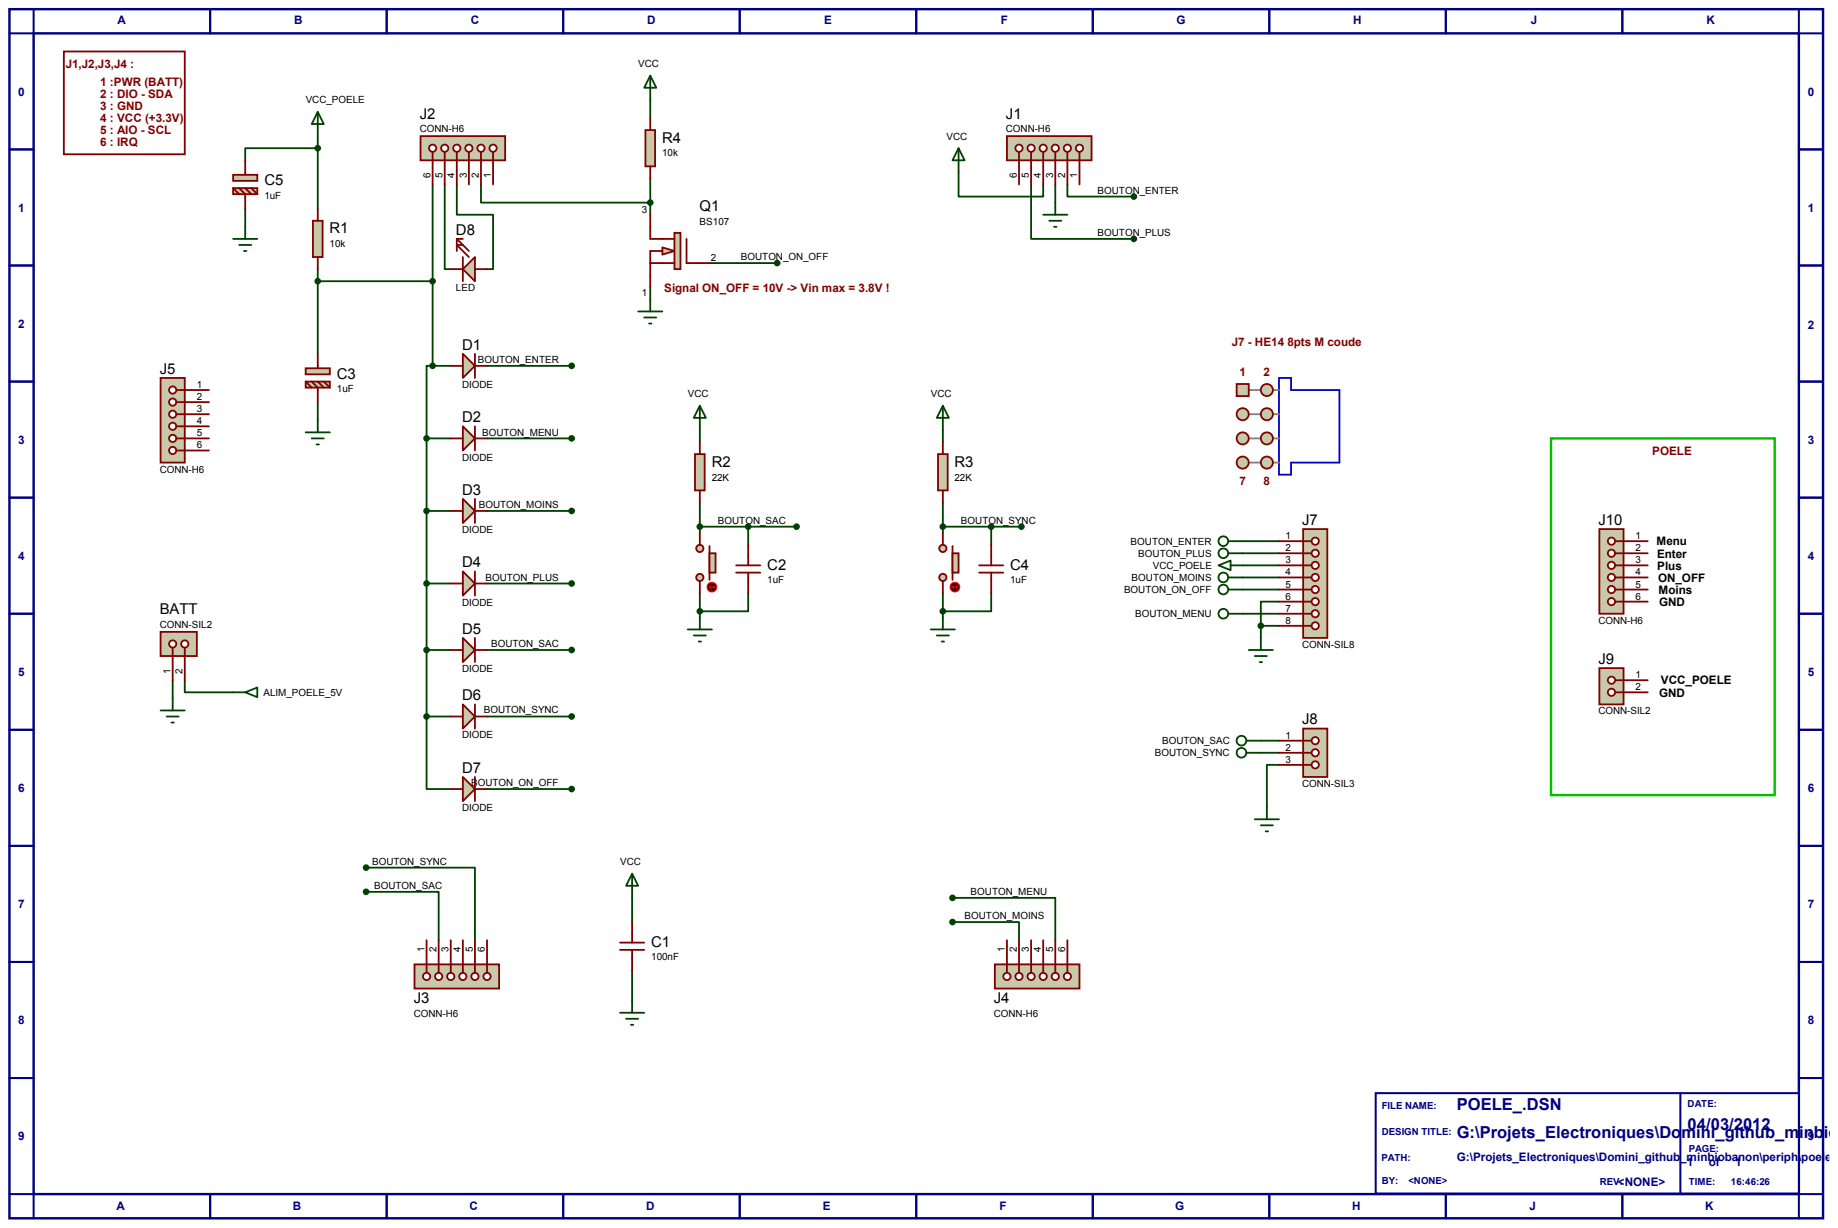
[picture p96: page 1]
