minbiocabanon/DoMini/periph/compteur_edf/Sch_JEENODE_TELEINFO.pdf

J1

J2

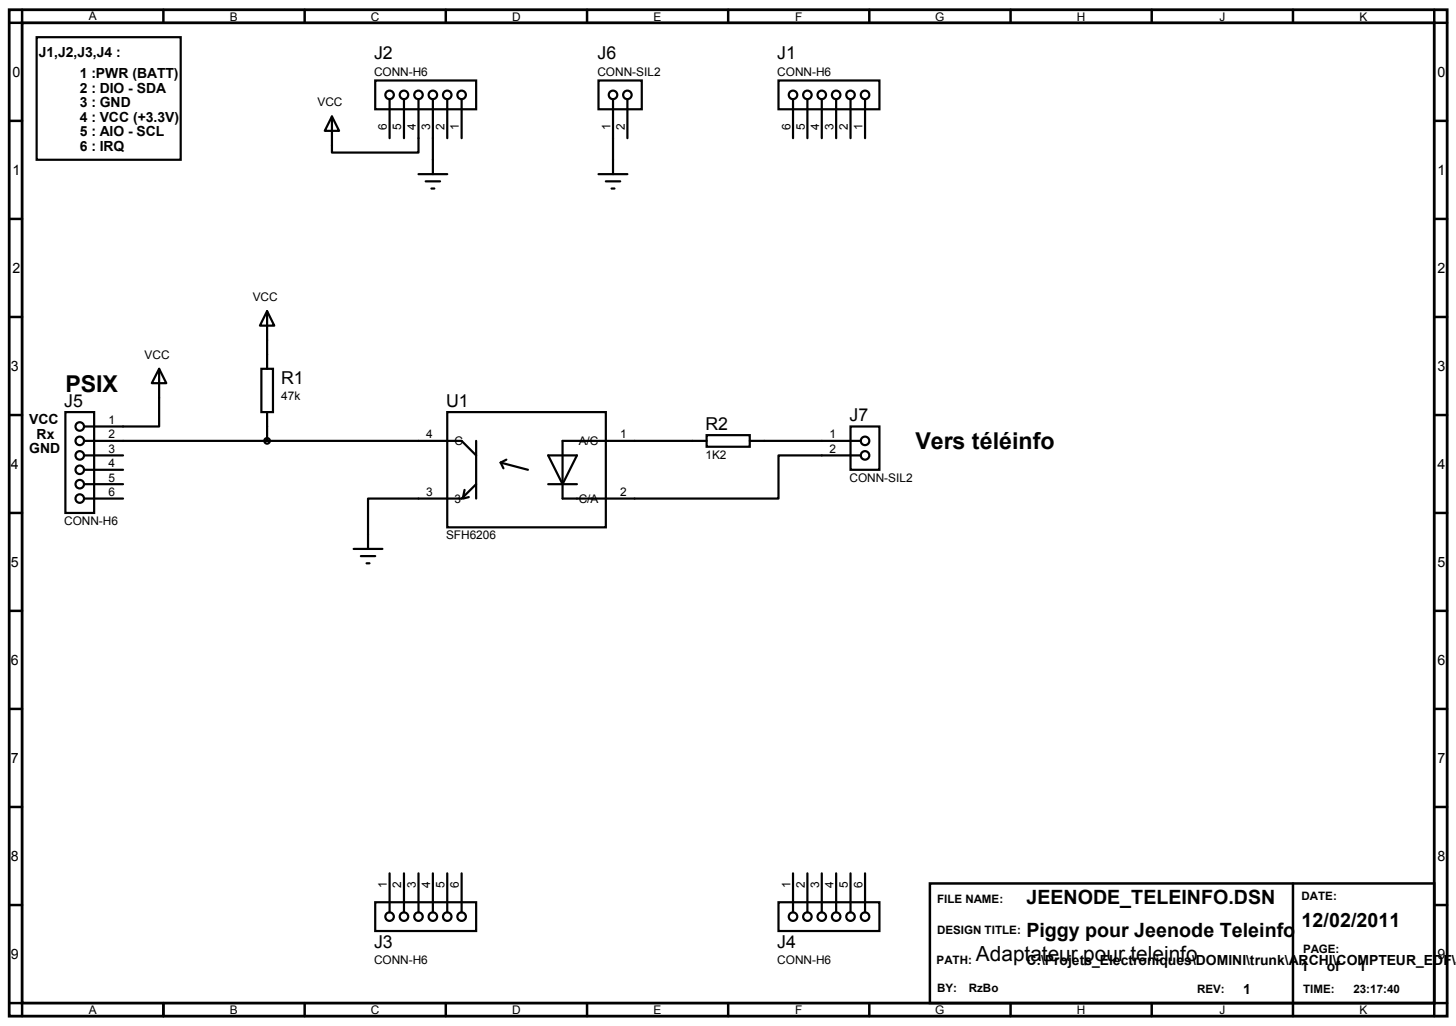
[picture p97: page 1]

FILE NAME:
DESIGN TITLE: Piggy pour Jeenode Teleinfo
Adaptateur pour teleinfo
