minbiocabanon/DoMini/periph/poele/Schema_RikaRio.pdf

## RX TX

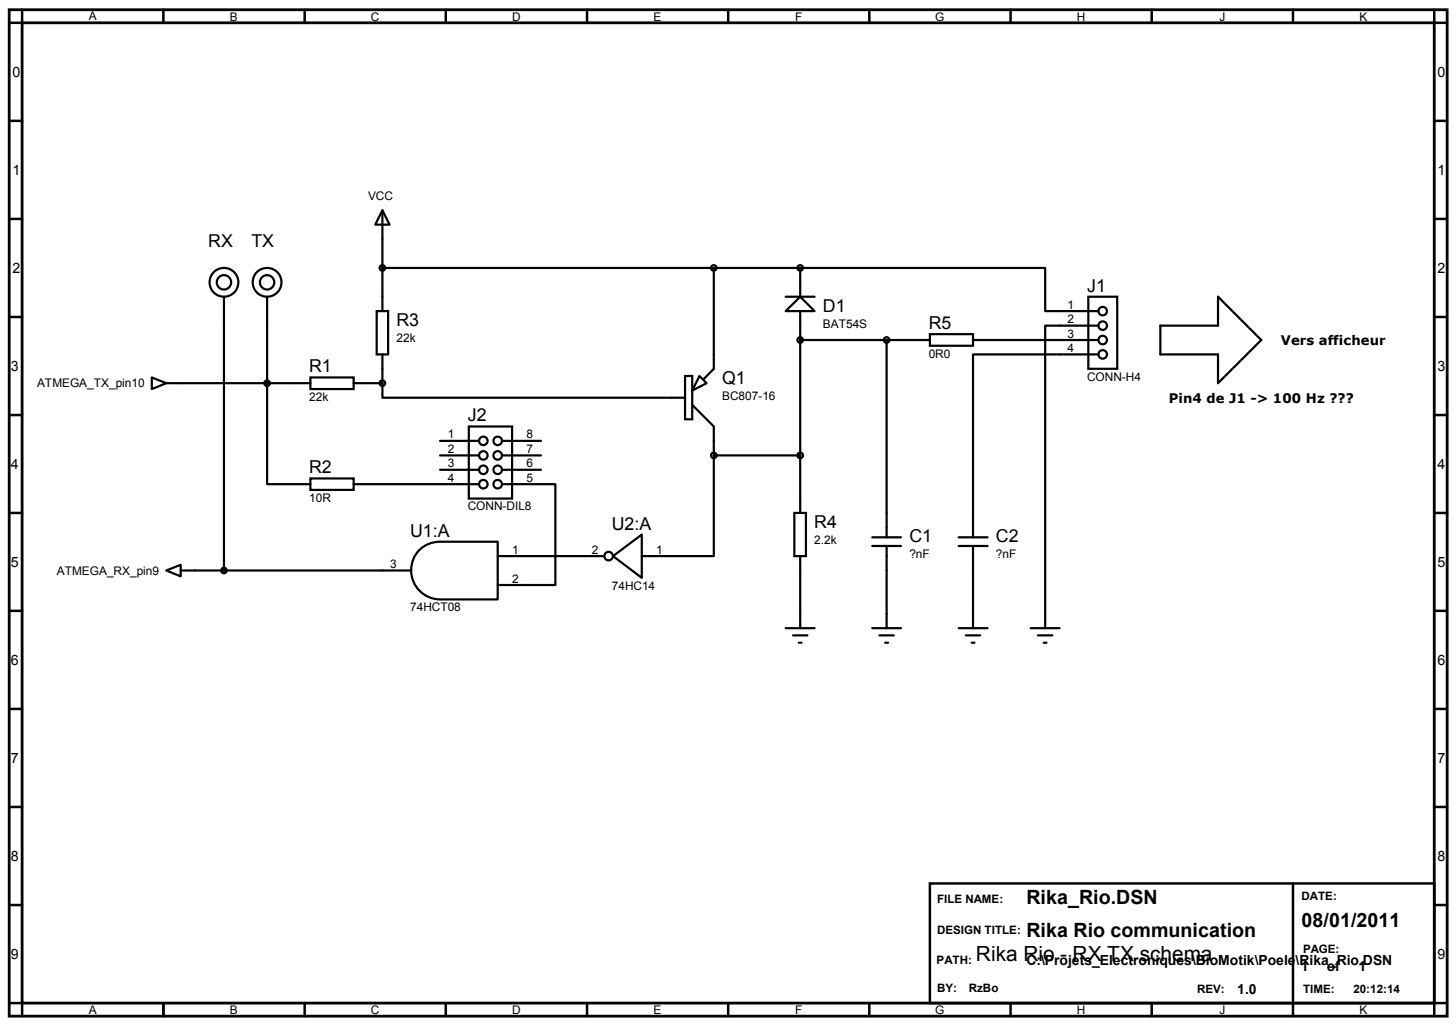
[picture p98: page 1]

FILE NAME:
DESIGN TITLE: Rika Rio communication
Rika Rio - RX TX schema
