minbiocabanon/DoMini/periph/pyranometre/Sch_PYRANOMETER.pdf

C1

J1

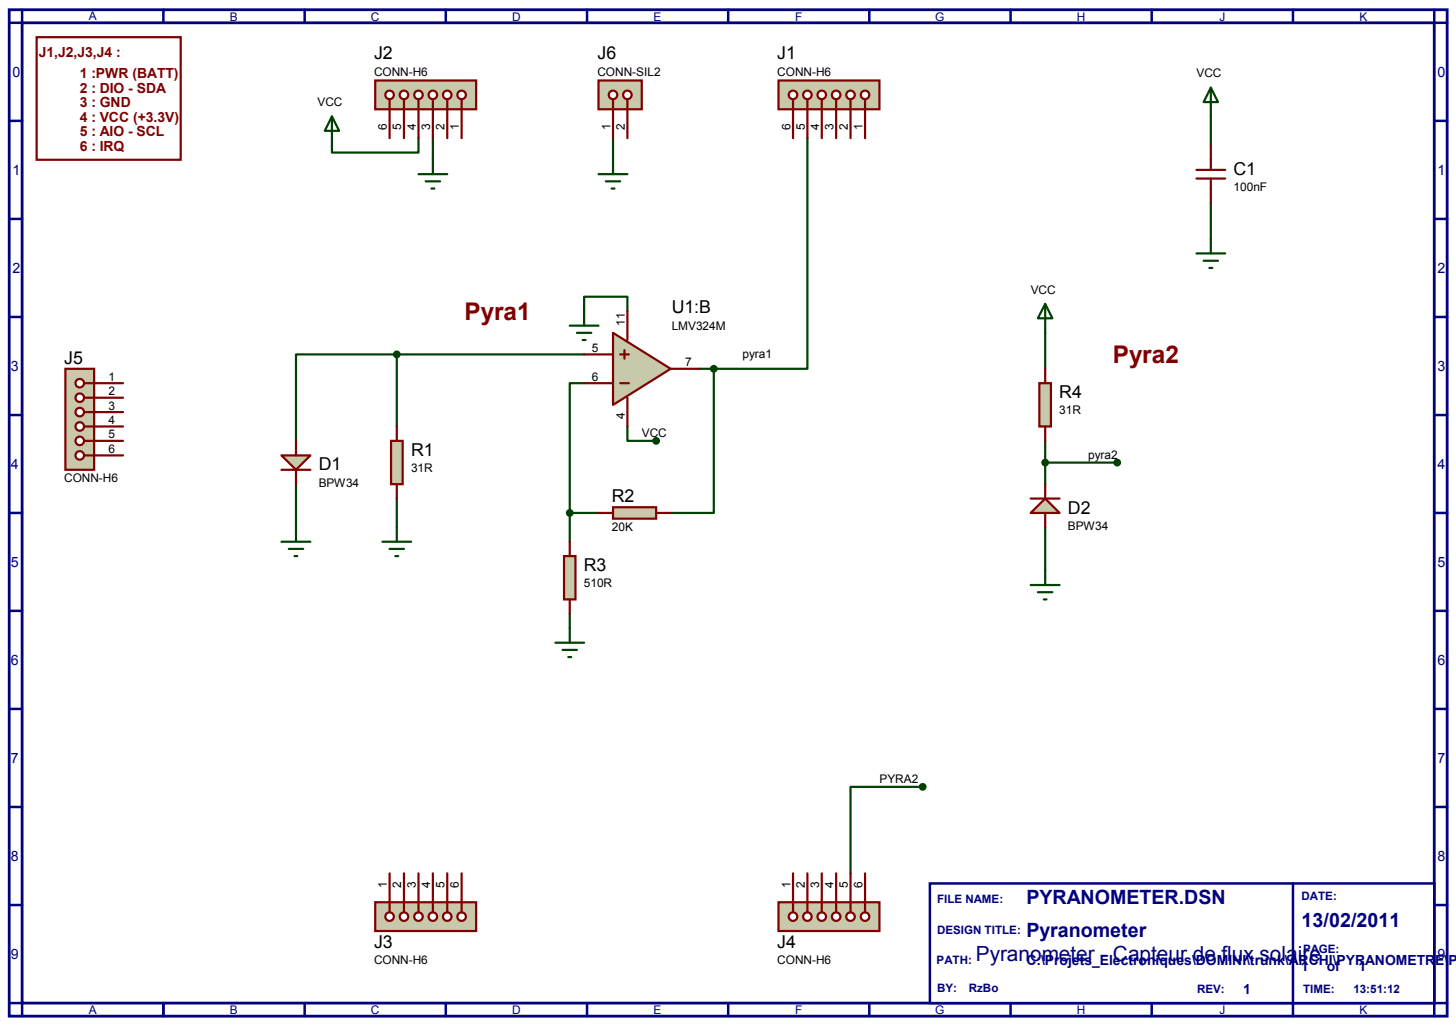
[picture p99: page 1]

DESIGN TITLE: Pyranometer
Pyranometer - Capteur de flux solaire
