minbiocabanon/DoMini/periph/vmcdf_bypass/Sch_VMCDF+bypass.pdf

U1

# CAPTEURS

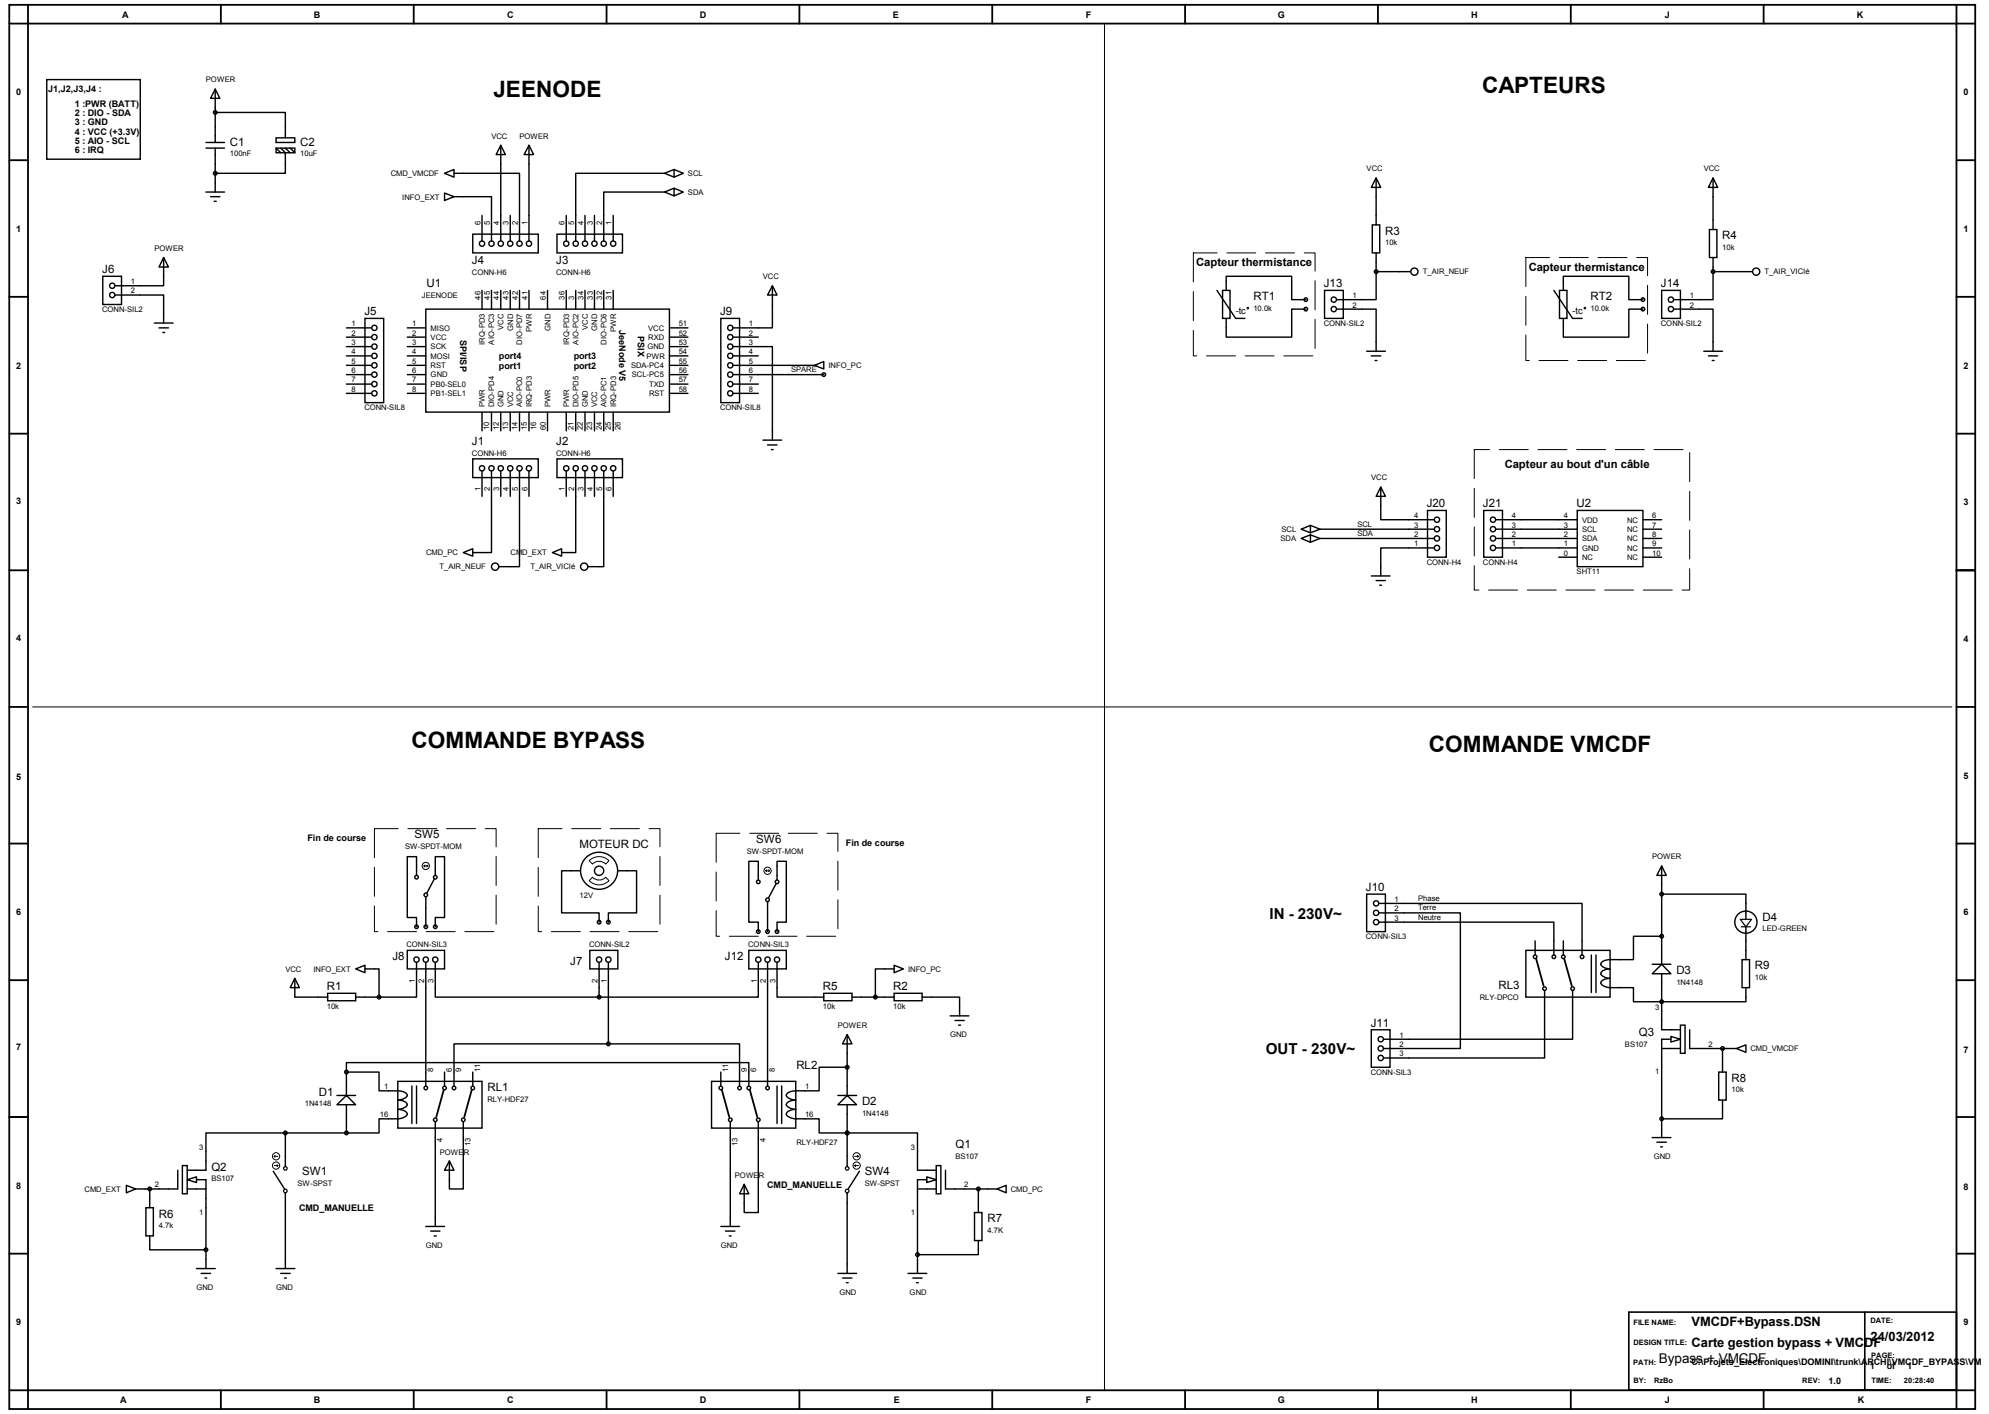
[picture p100: page 1]

Capteur au bout d'un câble

FILE NAME:
DESIGN TITLE: Carte gestion bypass + VMCDF
Bypass + VMCDF
