minbiocabanon/DoMini/periph/vmcdf_bypass/VeroBoard_VMCDF_Bypass.pdf

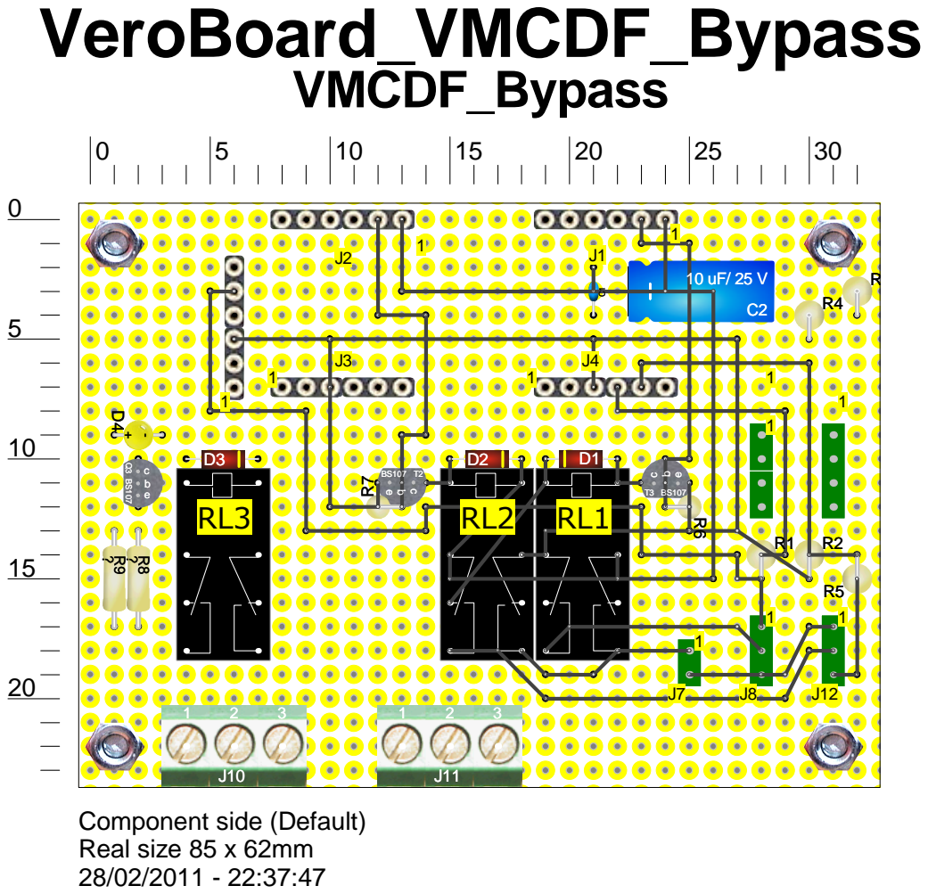
[picture p101: page 1]
