minbiocabanon/DoMini/periph/voletroulant/Cablage_Somfy_Telis_4_RTS.pdf

UP

My

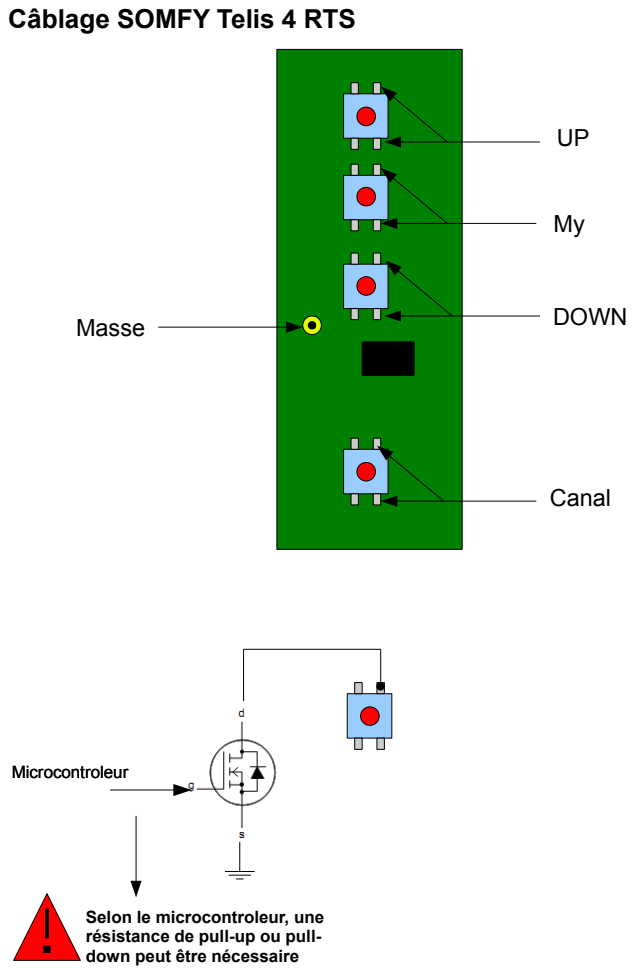
[picture p102: page 1]
Masse; DOWN; Canal; Microcontroleur

Câblage SOMFY Telis 4 RTS

Selon le microcontroleur, une
résistance de pull-up ou pull-
down peut être nécessaire
