minbiocabanon/DoMini/periph/voletroulant/TELECO_SOMFY.pdf

J1

J2

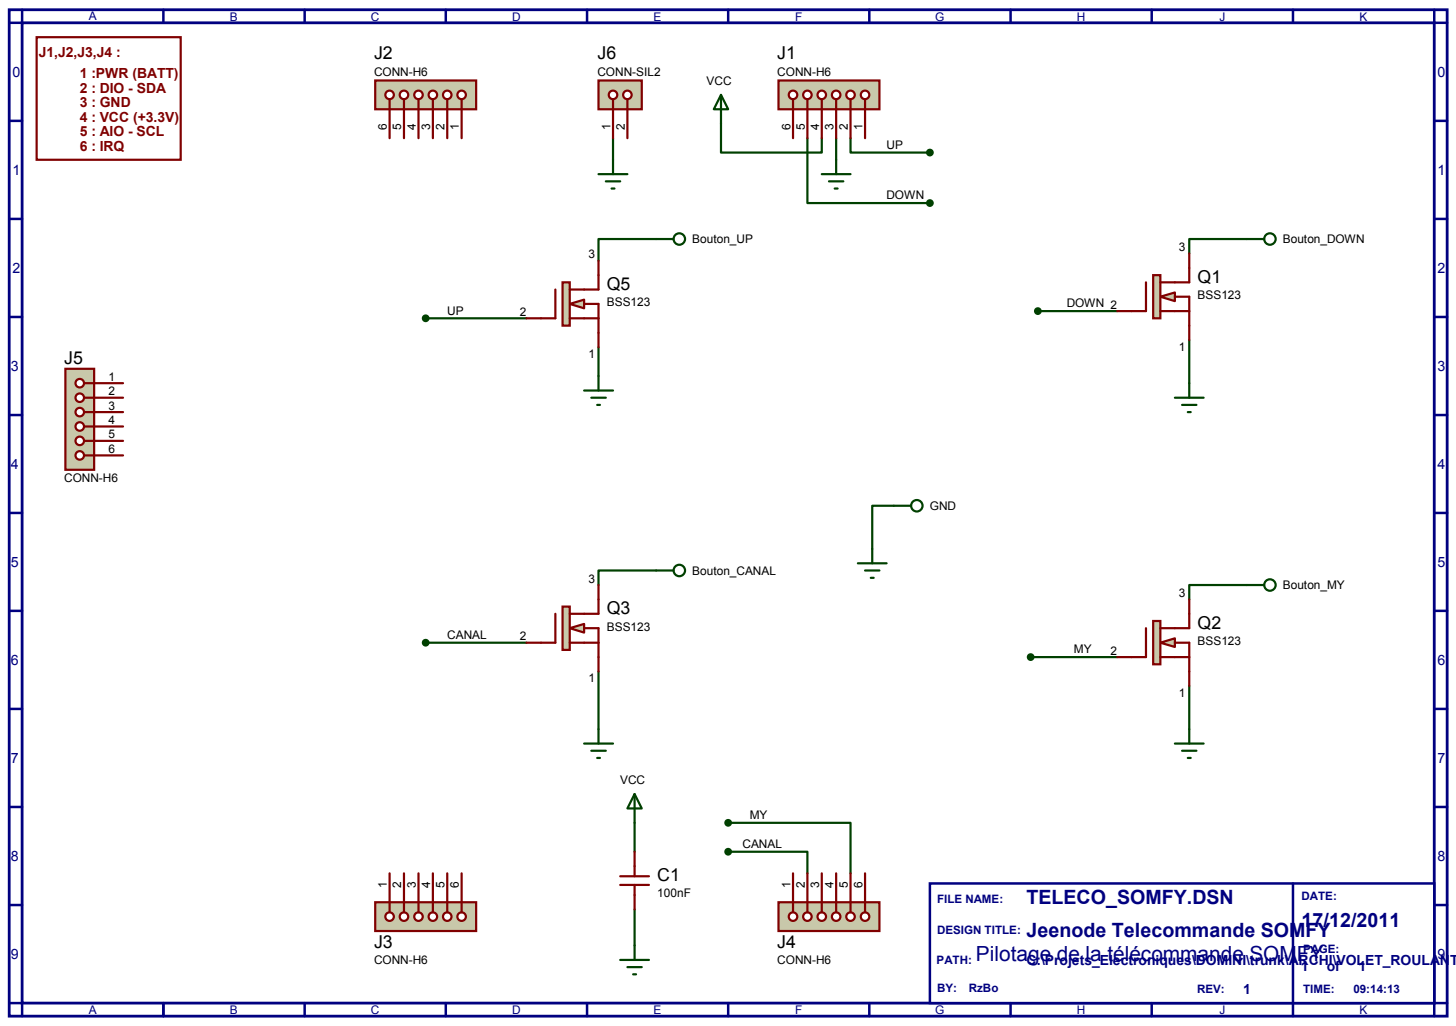
[picture p103: page 1]

FILE NAME:
DESIGN TITLE: Jeenode Telecommande SOMFY
Pilotage de la télécommande SOMFY
