minbiocabanon/DoMini/periph/sonde_temperature/docs/Schema_AAPowerBoard_Jeenode.pdf

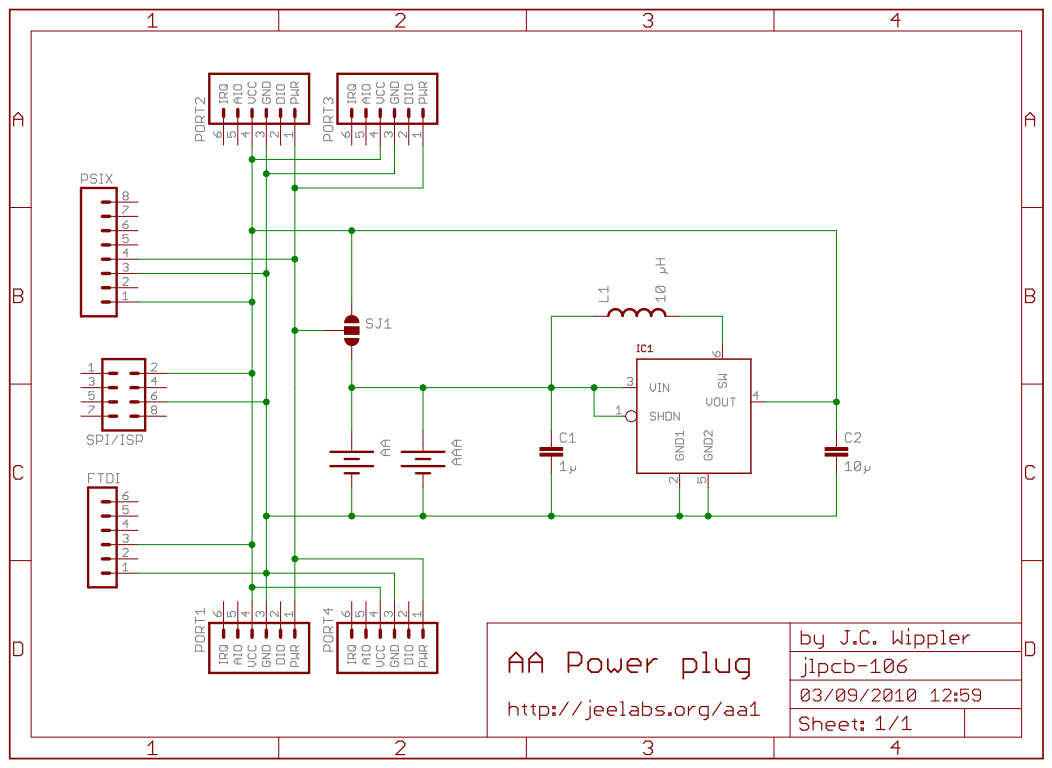
[picture p104: page 1]
