minbiocabanon/DoMini/periph/sonde_temperature/docs/Schema_RoomBoard_Jeenode_SHT11.PDF

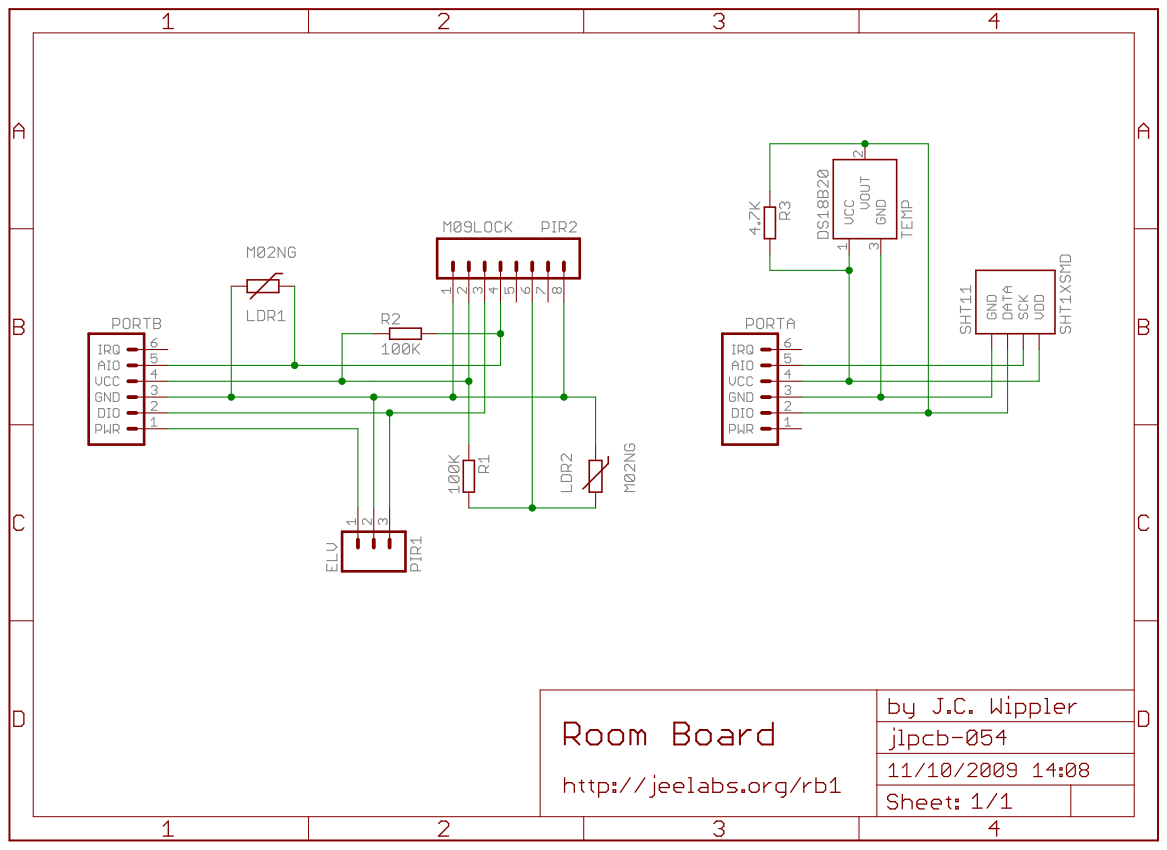
[picture p105: page 1]
