minbiocabanon/DoMini/periph/station_meteo/PCB/IMPLANTATION/CI13-001_implantation_V2.pdf

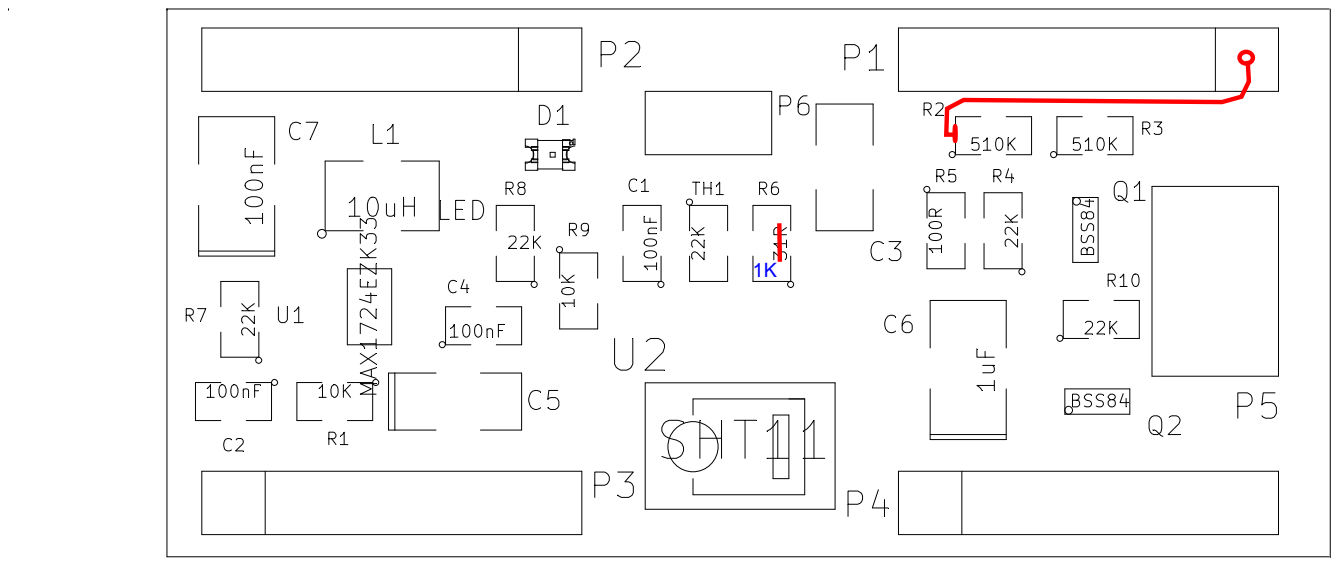
[picture p106: page 1]
