minbiocabanon/DoMini/periph/station_meteo/PCB/IMPLANTATION/CI13-001_implantation.pdf

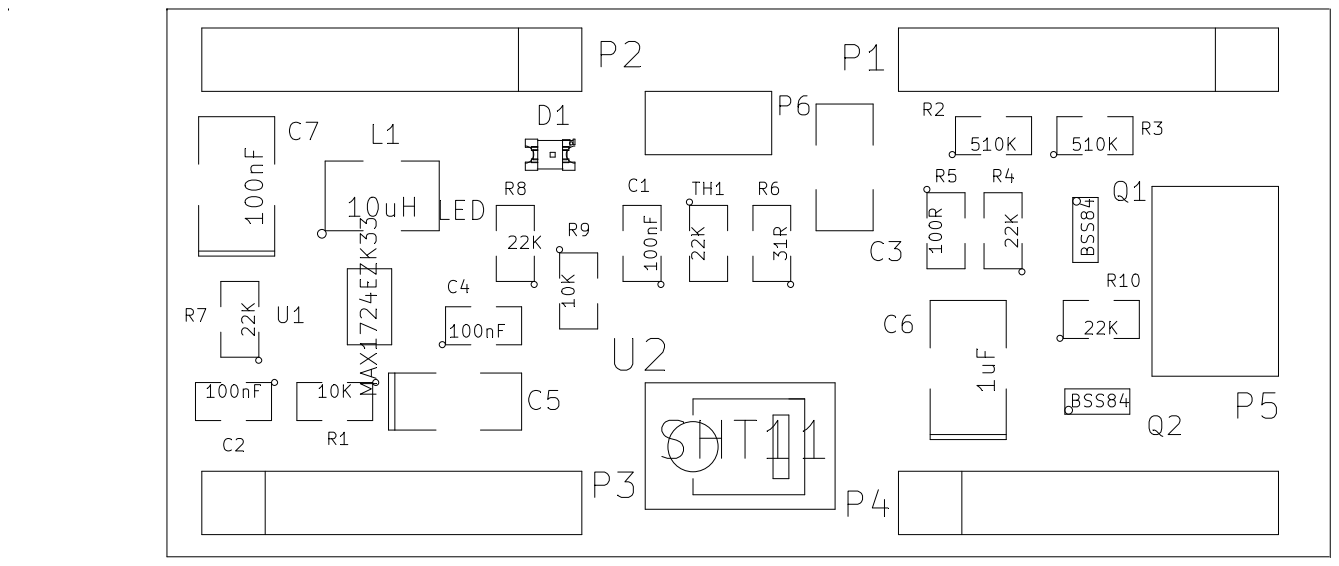
[picture p107: page 1]
