minbiocabanon/DoMini/(list of files, drawings)

Other design files:
periph/compteur_edf/Sch_JEENODE_TELEINFO.DSN
periph/congelo/CONGELO.DSN
periph/poele/jeenode_shield_POELE.DSN
periph/poele/Schema_RikaRio.DSN
periph/pyranometre/PYRANOMETER.DSN
periph/sonde_temperature/THERMO_HUMID.DSN
periph/vmcdf_bypass/Sch_Proto_Commande_relais_bypass.DSN
periph/vmcdf_bypass/VMCDF+Bypass.DSN
periph/voletroulant/TELECO_SOMFY.DSN
