minbiocabanon/DoMini/periph/station_meteo/PCB/V1/JeeNode.kicad_pcb

## KiCad design periph/station_meteo/PCB/V1/JeeNode.kicad_pcb (2016-11-28)

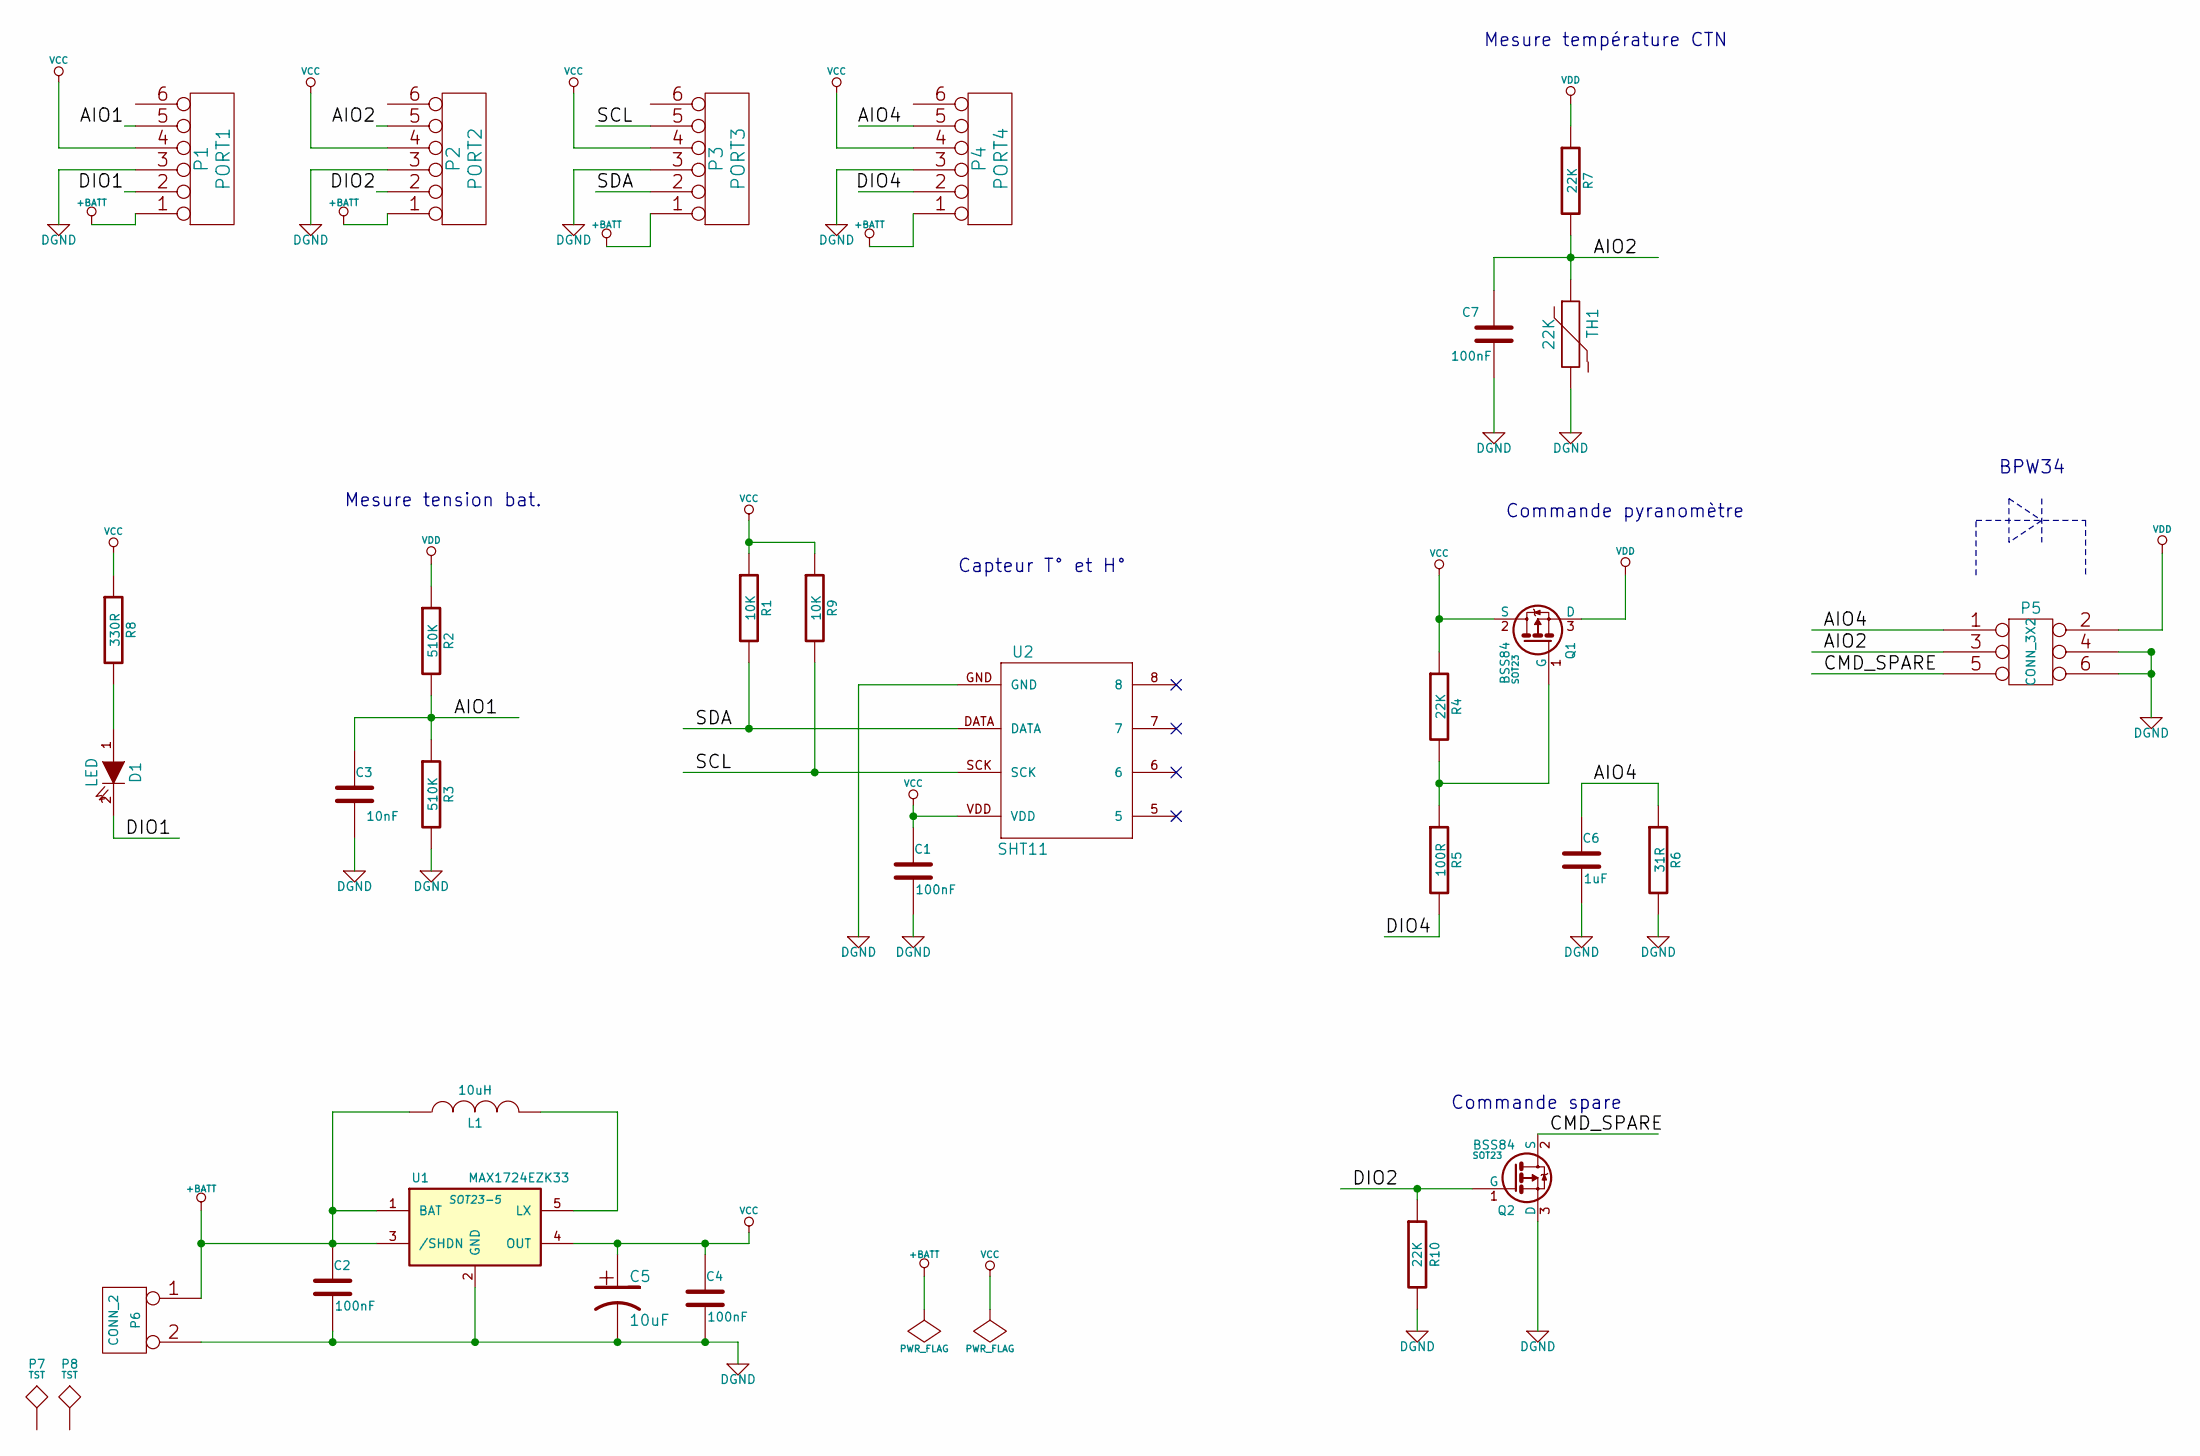
[picture p108: schematic JeeNode.sch, JeeNode shield - Sensors & GPIO]

Parts:
C1, C2, C4: 100nF; SM0805
C3: 10nF; SM1206
C5: 10uF; SM1206POL
C6: 1uF; SM1210L
C7: 100nF; SM1210L
D1: LED; LED-0805
L1: 10uH; SM1210
P1: PORT1; PIN_ARRAY-6X1
P2: PORT2; PIN_ARRAY-6X1
P3: PORT3; PIN_ARRAY-6X1
P4: PORT4; PIN_ARRAY-6X1
P5: CONN_3X2; pin_array_3x2
P6: CONN_2; PIN_ARRAY_2X1
P7, P8: TST; Hole_1mm
Q1, Q2: BSS84; SOT23
R1, R9: 10K; SM0805
R2, R3: 510K; SM0805
R4, R7, R10: 22K; SM0805
R5: 100R; SM0805
R6: 31R; SM0805
R8: 330R; SM0805
TH1: 22K; SM0805
U1: MAX1724EZK33; SOT23-5
U2: SHT11; sht11-SHT11

Connections:
+BATT: C2.1, L1.1, P1.1, P2.1, P3.1, P4.1, P6.1, U1.1 (BAT), U1.3 (/SHDN)
/AIO1: C3.1, P1.5, R2.2, R3.1
/AIO2: C7.1, P2.5, P5.3, R7.2, TH1.1
/AIO4: C6.1, P4.5, P5.1, R6.1
/CMD_SPARE: P5.5, Q2.2 (S)
/DIO1: D1.2 (K), P1.2
/DIO2: P2.2, Q2.1 (G), R10.1
/DIO4: P4.2, R5.2
/SCL: P3.5, R9.2, U2.SCK
/SDA: P3.2, R1.2, U2.DATA
DGND: C1.2, C2.2, C3.2, C4.2, C5.2, C6.2, C7.2, P1.3, P2.3, P3.3, P4.3, P5.4, P5.6, P6.2 (PM), Q2.3 (D), R3.2, R6.2, R10.2, TH1.2, U1.2 (GND), U2.GND
unnamed: Q1.1 (G), R4.2, R5.1
unnamed: L1.2, U1.5 (LX)
unnamed: D1.1 (A), R8.2
VCC: C1.1, C4.1, C5.1, P1.4, P2.4, P3.4, P4.4, Q1.2 (S), R1.1, R4.1, R8.1, R9.1, U1.4 (OUT), U2.VDD
VDD: P5.2, Q1.3 (D), R2.1, R7.1

Notes on the sheet:
Mesure tension bat.
Capteur T° et H°
Commande pyranomètre
Mesure température CTN
Commande spare
BPW34

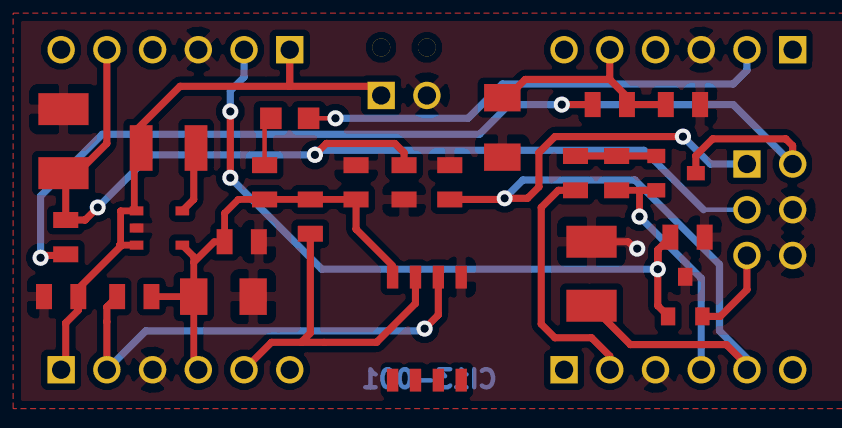
[picture p109: board JeeNode.kicad_pcb from above]

Board: 2 copper layers, 32 parts (0 on the bottom side), 16 nets.
