minbiocabanon/DoMini/serveur/www/domini/webcam/resources/galleryConfig.ini

; This is the default UberGallery config file. Copy this file to galleryConfig.php
; and change the following values to customize your gallery.

[basic_settings]

    cache_expiration    = 5             ; Cache expiration time (in minutes)

    enable_pagination   = true         ; Set to 'true' to enable pagination

    paginator_threshold = 10            ; Maximum number of pages to display
                                        ; in the paginator before truncating

    thumbnail_width     = 128           ; Thumbnail width (in pixels)

    thumbnail_height    = 72           ; Thumbnail height (in pixels)

    thumbnail_quality   = 75            ; Thumbnail quality from 1 - 100
                                        ; Higher = better quality / slower

    theme_name          = uber-blue     ; Theme used to style the gallery


[advanced_settings]

    images_per_page     = 24            ; Images displayed per page, requires
                                        ; enable_pagination be set to 'true'

    images_sort_by      = natcasesort   ; Method used to sort image array
                                        ; Available sorting options include:
                                        ; asort, arsort, ksort, krsort,
                                        ; natcasesort, natsort, shuffle

    reverse_sort        = true         ; Set to 'true' to reverse sort order

    enable_debugging    = false         ; Output debug messages
