minbiocabanon/DoMini/(commit log)

2014-08-02 Ajout répertoire docs/ (commit repertoire par répertoire car pb de bande passante)
2014-08-02 Ajout repertoire serveur/ -> contient tous les logiciels qui tournent sur le PC domotique (Linux), les scripts, l'interface web (www) et les configs systeme (cron, bdd, ...)
    (ajout repertoire par repertoire car pb de bande passante)
    [Def_planning.csv, calcul_puissance_départ.xls, calcul_regulation.xls, consigne_pc.csv, pellet.csv, pellet_conso.csv, puissance_pc.csv, pyrano.csv]
2014-08-02 ajout repertoire periph/ , contient les schemas, codes sources et docs concernant les modules jeenodes/arduino.
    [BOM-JeeNode.csv, BOM-JeeNode.ods, CONGELO.DSN, CTN22K.xls, Config_RF12.ods, Conversion_BPW34_Watt.xls, Enthalpie.ods, Identification_Jeenodes.xls]
2014-08-04 modification des makefile, ajouts de readme, et modification des scripts po faciliter le deploiement sur une nouvelle machine
2014-08-08 modif des Makefile pour copier les exe au bon endroit en relatif. ajout d'un script pour ajouter un lien dans/home/julien/bin:/usr/local/bin:/usr/bin:/bin:/usr/local/games:/usr/games:/home/julien/src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
2014-08-10 ajout screenshot de l'ihm web pour wiki/github
2014-08-10 modif des scripts pour ne plus generer de warnings
2014-08-12 modification des Makefile pour inclure un seul fichier password.h . ce .h contient les logins et password pour l'accea la bdd depuis les apapplis en C
2014-09-02 ajout test, log et graph de la connexion internet. mises � jour scripts
2014-09-03 - Ajout info sur schéma électronique pour le brochage de la BPW34 (.sch et .pdf)
    [JeeNode.sch]
2014-09-03 - mise à jour schematic du shield jeenode (png)
2014-10-11 - update sketche, la sonde est équipée d'un SHT11 + DC/DC pour améliorer autonomie de la sonde
2014-10-11 - update jeenode sketche et schéma pour gérer la capteur à ultrason pour mesurer niveau de granulés dans le réservoir
    [Identification_Jeenodes.xls, POELE_.DSN, Poele.fz, Poele.fzz, Schema_RikaRio.DSN, jeenode_shield_POELE.DSN]
2014-10-11 - correction page ventilation_flux.php et css pour corriger superposition des images
2014-10-11 - correction bugs sketche_poele.ino pour la gestion du telemetre ultrason
    [sketche_poele.ino]
2014-11-05 - correction sketche_poele/sketche_poele.ino : uniformisation timer pour gérer plusieurs évènements. Correction process pour mesure niveau granulés.
    [sketche_poele.ino]
2014-11-05 - correction nom de la table pour le niveau de granulés
    [receiver.c]
2014-11-05 - ajout fichiers php pour la gestion des graphs niveau de reservoir pellets - ajout plan support pour télémetre à ultrason pour la mesure de niveau de pellets dans le reservoir
    [support_telemetre_ultrason.skp]
2014-11-05 - correction nom de fichier dans csv_pellet_rsv.php
2014-11-13 - ajout lib_arduino/RunningMedian.zip pour le calcul de valeur mediane source : http://playground.arduino.cc/Main/RunningMedian
    - modif sketche_poele.ino pour calculer une valeur mediane sur le niveau de pellets dans le reservoir
2014-11-28 ajout camera
2014-12-02 del_old_data.c : ajout d'une table l a archiver. amelioration mineures sur l'envoi/reception de messsages
2014-12-07 camera garage validee, changement de nom dans les pages web et scripts
2014-12-13 Amelioration planning : possibilite de modifier la temperature
2015-01-04 Ajout pyReceiver : gestion UART du Jeelink en Python ! et correction bug divers
    [pyreceiver.py, receiver.c]
2015-01-04 - mise à jour planning/Def_planning.csv - corresion petit bug dans sketche_poele.ino
    [Def_planning.csv]
2015-01-04 correction bug pyreceiver : manque un LF a la fin du message
    [pyreceiver.py]
2015-01-17 fix POL message bug
    [pyreceiver.py]
2015-01-17 ftp.sh s a jour, ne fonctionnait plus depuis la migration sur le PC x86.
2015-01-21 changement page index , ajout vignettes camera a la plage de la meteo. changement des heures/jour pour uploard sur site miroir free. ajout creation de vignettes avec redim.php
2015-01-30 info rsv granules : change cm pour des pourcents pour la page index
2015-02-07 emitter et receiver supprimés, désormais l'envoi/reception des messages est géré par pyReceiver.py !
2015-02-07 ajout de quelques blindage pour éviter que pyReceiver/pyreceiver.py ne plante si pas de BDD ou si pas de portCOM detecté
2015-02-07 ajout de blindage dans pyreceiver : evite de planter si pas mysql pas dispo ou si port com occupe
2015-02-09 mise a jour suite gros bug qui avait face des scripts
2015-03-14 creation de script pour generer les csv de teleinfo complet dans le cas de la perte des csv( c'est arrive). amelioration de scripts divers.
2015-06-15 pyreceiver.py : suppression retour chariot a la windows
2015-08-12 corrections de divers bugs sur plusieurs pages et script
2015-10-10 update crontab and fix bug on pyreceiver
    [pyreceiver.py]
2015-12-13 Gestion des message $DBG , afin de mieux afficher les mesages de debug du jeelink
2015-12-31 planning.c : ajout d'un argument pour determiner l'annee pour laquelle creer les tables planning. cela permet de creer les tables 2016 alors qu'on est qu'en 2015. Avant le programme utilisait l'annee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
2016-01-18 ajout fichier Log_batteries.txt pour mémoriser les dates de recharge des accus (à remplir manuellement)
2016-05-08 ajout surveillance capteurs VMC, combles, garage,... . Nouvelle camera, modifs scripts lies a la surveillance
2016-05-22 message de commande manuelle bypass PC avec ACK
2016-06-04 ajout pyBypassPC en version python, la version en C sera supprimmee au prochain commit. correction de quelques bugs mineurs
    [pyreceiver.py]
2016-10-13 pyreceiver : ajout pySentinelle.py pour surveiller les process. Envoi notif pushbullet en cas de pb. mise a jour de srouces divers egalement.
2016-11-05 ajout de blindage sur la réception et le controle des etats, car parfois le jeenode semble lancer des commandes non desirées !!!
2016-11-28 - correction sur schematic et PCB de la station météo : erreur sur valeur de résistance et polarisation du pont diviseur pour la mesure de tension batterie
    [BOM-JeeNode.csv, BOM-JeeNode.ods, JeeNode.kicad_pcb, JeeNode.sch, JeeNode_V2.sch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]
2016-11-30 sauvegarde projet kicad station meteo
2016-11-30 correction bug sur effacement buffer : réalisé dans la boucle principal, prenait beaucoup de ressources CPU !
    [sketche_voletroulant.ino]
2016-12-01 migration interface web en PHP7 , possible bugs ou fichiers indesirables dans ce commit... nettoyage a faire prochainement
    [chauffage_log.csv, consigne_pc.csv, pellet.csv, pellet_conso.csv, pellet_rsv.csv, puissance_pc.csv, pyrano.csv, pyrano_an.csv]
2016-12-01 mise en 'ignore' fichiers csv , temporairement pour éviter d'écraser les fichiers récents (migration de domini sur une nouvelle machine)
    [chauffage_log.csv, consigne_pc.csv, pellet.csv, pellet_conso.csv, pellet_rsv.csv, puissance_pc.csv, pyrano.csv, pyrano_an.csv]
2016-12-01 suppression reference a l'exec (langage C) de regul_temp dans www/domini/bin , , remplace par lien symbolique vers python
2016-12-01 correction bug dans restore_donnees_instant.php qd on est en mode manuel : les donnees affichees sur la page web etaient erronees. ajout lien symbolique pygestion_vr.pv dans www/domini/bin
2016-12-03 correction bug, un argument de trop dans requete mysql
2016-12-17 correction fichier php pour eviter les valeurs NULL dans les variables car mysql refusait la requete
2016-12-19 changement de droits des scripts
2016-12-19 bug avec php7, ajout du controle de la valeur de retour dans instant_data.php pour eviter erreur mysql
2016-12-19 remplacement de l'appel du binaire en C par l'equivalent en python
2016-12-19 mise a jour de la liste des paquet installes
2017-01-07 mise à jour Synoptique_DoMini.odg , suppression mention sheeva plus et capacité du disque dur
2017-02-04 recompilation de regul_temp.c sur nouvelle machine et correction de bug ou warning
2017-02-09 ajout dossier ups pour tout ce qui concerne la gestion de l'onduleur (dialogue USB)
2017-02-14 mise à jour des paquets utilises
2017-02-20 gestion de l'onduleur avec des scripts python, permet d'envoyer des messages via pushbullet. tentative de lancer le gestionnaire en tant que daemon
2017-02-22 pour les scripts python, ajout d'une fonction commit avec un requete mysql afin d'etre sur que les donnees soient poussees en bdd
2017-02-22 ajout de log en bdd pour ups_daemonized
2017-02-23 ajout de l'affichage des infos relatives a l'ondeleur sur la page web domini
2017-02-25 ajout pyNiveauGral , pour envoyer des notifications lorsque le reservoir du poele est trop bas (pushbullet)
2017-02-25 amelioration du test serveur web dans la sentinelle
2017-02-27 conversion tri_bdd_edf en pytribdd_edf. amelioration du script qui permet de passer en arg une date de debut de nettoyage.
2017-03-01 ajout pytribdd.py pour usage de maintenance en cas de non fonctionnement des tache cron. si les tables n'ont pas ete nettoyees depuis un certain temps, il est possible de lancer manuellement le netto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
2017-03-01 mise a jour de README.md
2017-03-03 correction bug sur un message de debug, suppression de message dans syslog pour ne pas le surcharger
2017-03-03 correction erreur dans message de debug
2017-03-04 correction bug sur page qui affiche les conso annuelles de pellets
2017-03-04 suppression boite de dialoque qui ne servrait qu'au debug
2017-03-05 suppression page pepette.php qui permettait de surveiller le chat. RIP Pepette
2017-03-06 correction bug sur requete pour l'heure de demarrage, empechant la creation de log a partir d'une table vide
2017-03-06 ajout condition en PHP, pour eviter warning dans les logs
2017-03-06 suppresion du forcage des couleurs, couleurs par défaut laissees
2017-06-13 correction bug dans pygestion_vr.py : variable non declaree ajout de log pour la requete mysql envoyee
2017-09-28 modification @ ip pour le test wifi. ajout de kill car des fois ca coince
2017-09-28 mise a jour de la liste des paquets
2017-10-19 correction bug : manque un : sur appelle de fonction
2017-10-19 ajout d'un tag time pour les images afin de contourner le cache du navigateur internet
2017-12-02 ajout d'un script php pour compter la conso de pellets par hiver. pas d'affichage sur l'IHM pour l'instant
2017-12-02 ajout de quelques infos : dynddns, bios, ...
2017-12-02 mise à jour des infos pour l'installation de UPS
2018-01-01 planning : correction makefile et adaptation a la nouvelle api mysql
2018-04-01 modification temporaire pour nouvelle camera. je passe par un Rpi pour la capture d'image. en attendant de pouvoir faire la capture directement depuis DoMini. Pour l'instant je suis bloque par l'inst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
2019-01-01 ajout de la suppression des infos de l'année précédente dans la table 'calendrier' sinon le logiciel planning n'arrivait pas à affecter aux lignes de l'année en cours, les infos de temperatures.
2019-01-01 correction bug dans le script de backup, il manquait le chemin d'execution. La recup des donnees de connexion ftp deplacee pour etre sur que la sauvegarde locale se fasse (en cas d'erreur ni, la sauv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
2019-01-01 correction bug dans l'affichage de message de log qui faisait planter le script
2019-01-01 ajout d'un critere pour tagger une ligne afin d'accelerer le processus : on tagge la ligne qui si elle n'est pas deja tagguee.
2019-01-02 ajout lancement daemon ups dans le go.sh , cela permet d'avoir la bdd rempli avec l'état de l'onduleur et les noticfications pushbullet
2019-01-02 correction gros bug dans pytribdd : seule la table analog1 avait ses donnees supprimees ! les autres tables etaient taggees mais les donnees non supprimees a cause d'un sale copie-colle qui decalait 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
2019-01-03 correction bug dans la copie du syslog : le nom avait changé + changement de droit d'accès
2019-01-03 correction erreur de chemin pour le crontab. ajout du crontab à jour
2019-01-17 mise a jour numero Token pushbullet. Modif dans le daemon ups pour eviter de depasser le nb de requete max par mois (500)
2019-01-20 changement de camera dans le garage (une revotech de plus). scripts modifiés en conséquence. ajout d'une page kiwi.php qui servira de façon temporaire (ou pas)
2019-01-20 ajout d'un script de test pour pushbullet
2019-01-20 ajout fichier ups contenant les valeurs des variables dde l'onduleur
2019-01-24 mise en commentaire d'une ligne de debug
2019-01-26 changement de rep pour les images ext -> jardin
2019-01-27 mise a jour page reseau.php avec les nouvelles adresses IP
2019-01-27 Ajout d'un script phyton pour commencer la gestion d'une alarme. pyCaptureCam enregistre les camera lorsque les detecteurs de presence detecte un mouvement
2019-01-29 separation page camera live et galerie d'images enregistrées
2019-07-26 correction bug dans pytribdd : il manquait un commit pour appliquer la suppression des lignes non taggees. du coup, la bdd ne faisait que grossir.
2019-07-26 ajout de la gestion du module de detection infrarouge PIR pour l'alarme... en mode TEST pour l'instant
2019-07-26 Ajout de la commande commit apres un delete dans mysql pour appliquer les modifs dans la bdd.
2019-08-08 Ajout de la surveillance du daemon qui gere l'onduleur car si la table onduleur est vide cela bloque la recuperation des donnees (script php restore_donnee)
2019-11-13 correction condition de comparaison pour le niveau de granules dans le reservoir. enorme bug, comment ca a pu fonctionner avant ????
2019-11-13 correction sur requet mysql pour les scripts python
2019-11-14 correction bug dans la gestion des VR, cas degradé qui faisait planter sur un message de log et une variable non affectee
2019-11-16 finalement , il n'y avait pas de bug sur la comparaison pour l'alerte de niveau. on mesure la profondeur du reservoir, donc plus on mesure un reservoir profond, moins il y a de granule! il faut donc 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
2019-12-01 Ajout d'un message de debug affichant le message envoye au poele
2019-12-10 Ajout d'une réinitilisation du module radio rfm12 si aucun message n'est reçu pendant 15 minutes. Parfois, le module ne semble plus réagir aux envois de commande, cette évolution permettra de voir si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
    [sketche_poele.ino]
2020-09-05 changement mineur pour voir les erreurs php dans index.php
2020-09-05 ajout image 'kiwi' dans le carousel des images
2020-09-05 ajout d'une adresse supplémentaire dans les periph du reseau
2020-09-05 graph connexion internet genere toutes les 2 minutes
2020-09-05 changement des noms pour les images webcams du garage
2020-09-06 Pose du linky : ajout d'un offset dans les calculs pour l'affichage des courbes highstock
2020-12-08 ajout script pyCamClean qui permet de vider le cache de la galerie des images des cameras
2021-01-03 ajout d'info suite a installation sur nouvelle plateforme en ubuntu LTS 20.04 conversion en python3 des scripts
2021-01-03 mise à jour pour année 2021
    [Def_planning.csv]
2021-01-16 updraded to python3 and change some UART messages parsing code
2021-04-18 convert end of line to linux. change processthis default value to avoid python crash
    [pyreceiver.py]
2021-04-18 fix some http link for ip camera
2021-04-18 fix go.sh to able pyreceiver at startup after power outage
2021-05-01 change snapshot path : new camera
2021-05-15 change camera settings
2021-07-28 correction GROS BUG git add serveur/pyReceiver/pyreceiver.pygit add serveur/pyReceiver/pyreceiver.py Fuite memoire à cause de la créatio de la session MariaDB dans les fonctions receiver() et emitter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
    [pyreceiver.py]
2021-11-22 mise a jour Readme de pytribdd
2021-11-22 page de redirection ngrok
2021-11-22 sauvegarde liste des paquets
2021-11-22 mise à jour lien des cameras
2022-07-27 changement de camera IP pour le sejour, mise a jour commande et page reseau.php
2022-12-23 modification de la facon de reinitialiser le wifi si il est KO : usage de network manager
2023-01-21 correction bug sur surveillance de la bdd et ajout d'un restart de la bdd en cas de probleme
2023-01-21 changement de portCOM pour le JeeUSB
2023-02-25 optimisation : consigne manuelle sauvee dans PID afin de redemarrer en mode AUTO avec la même consigne que l'utilisateur. Evite de repartir avec la consigne parfois 0 ou 100 d'avant le passage en mod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
2023-03-05 correction php : la requete consistant a modifier deux tables en une seule fois ne fonctionne pas. Separation en deux requetes pour que ça marche
2023-12-31 2024 planning
    Ajout planning 2024
    Ajout d'un commentaire dans le fichier README pour l'usage du logiciel Planning
    [Def_planning_2024.csv, Def_planning_2024.ods]
2024-01-02 ajout debug dans planning pour trouver le probleme de la date fausse en debut d'annee
2024-01-02 correction bug : parametre change pour obtenir la date courante, l'annnee etait fausse !
2024-08-24 move sensor 'comble' to 'garage'
2024-10-15 last ocmmit, END OF PROJECT. Thank you DoMini ! New home, new home automation !
    [chauffage_log.csv, consigne_pc.csv, pellet.csv, pellet_bilan.csv, pellet_bilan_hiver.csv, pellet_conso.csv, pellet_rsv.csv, puissance_pc.csv]
